BigF25/Harvester-measurement-and-control-system/1.hardware/PCBProj/参考/ST-link/QQ截图20220219135628.jpg

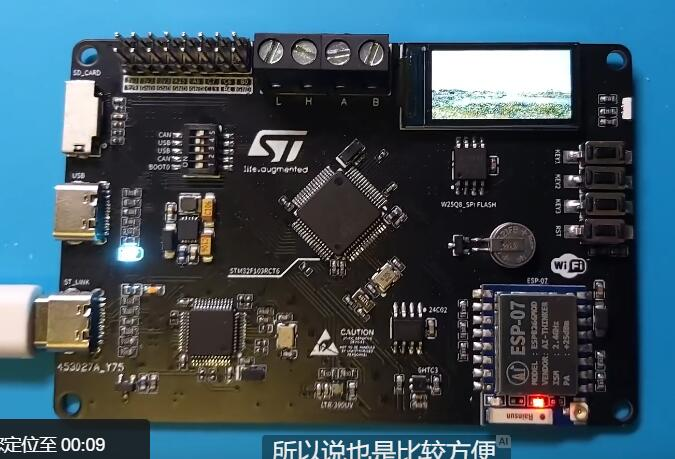
1.hardware/PCBProj/参考/ST-link/QQ截图20220219135628.jpg
