BigF25/Harvester-measurement-and-control-system/2.software/2-code/past/chuankouping/images/ID_0主界面按下.jpg

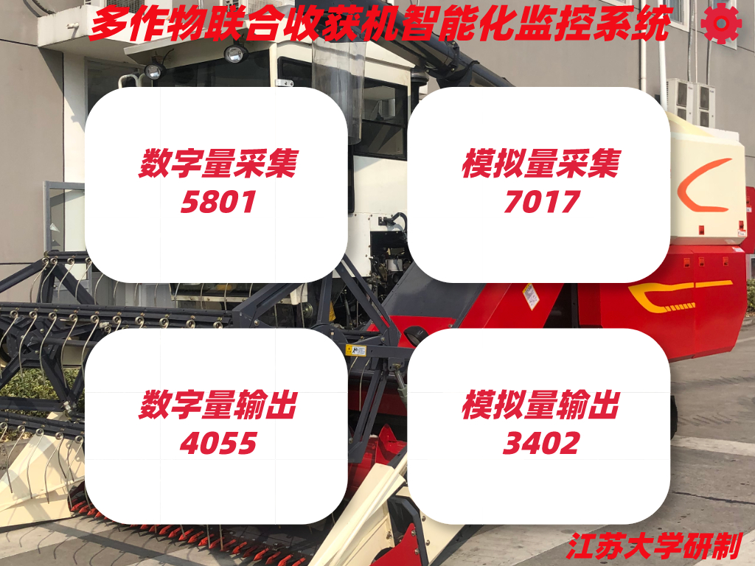
2.software/2-code/past/chuankouping/images/ID_0主界面按下.jpg
