BigF25/Harvester-measurement-and-control-system/3.docs/发票/嘉立创68元 (1).pdf

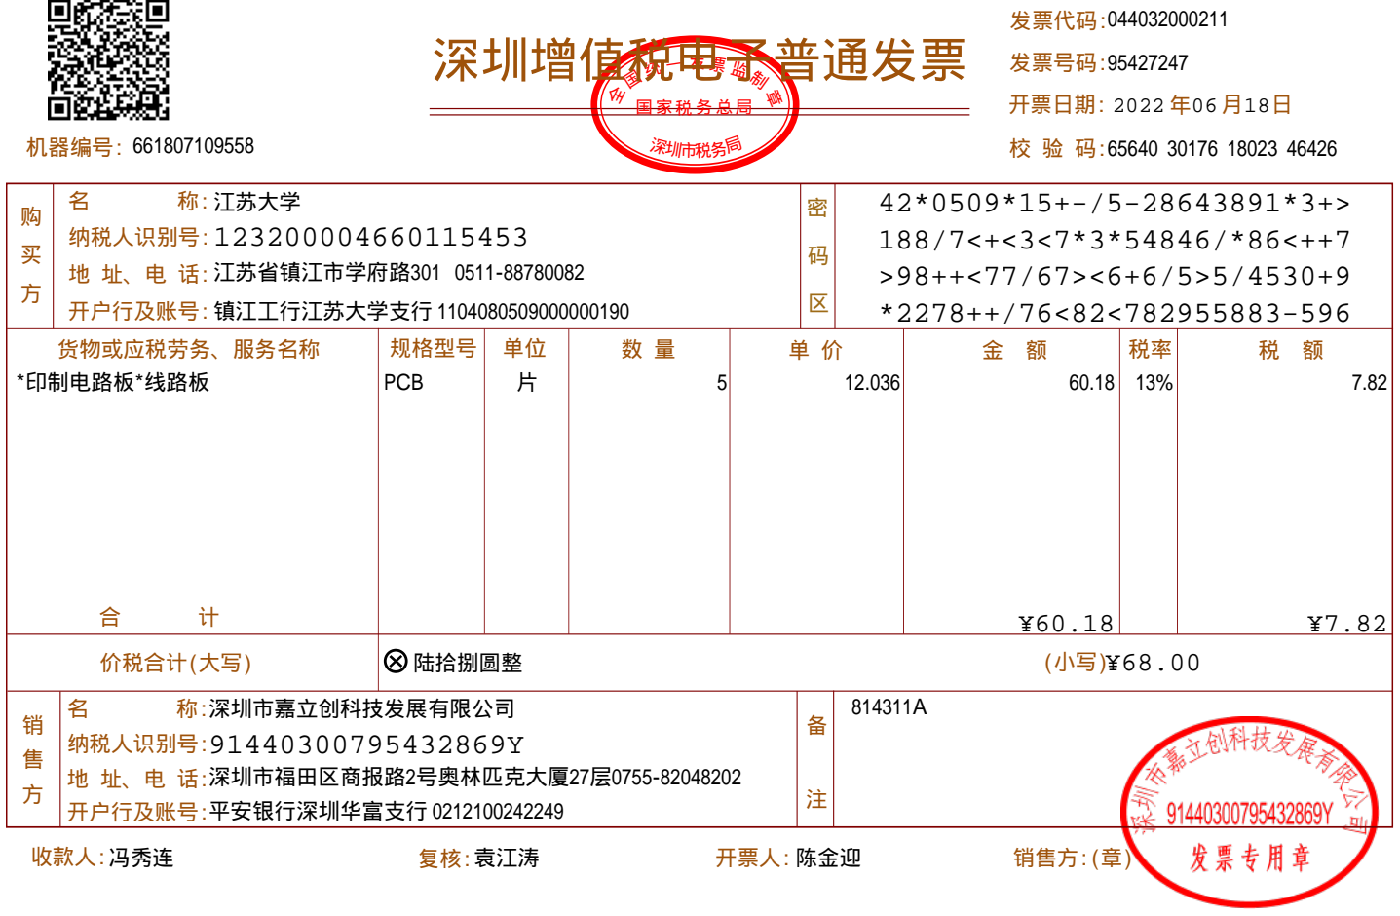
[picture p14: figure]
价税合计(大写); 纳税人识别号:; 开户行及账号:; 收款人:; 开票人:; 销售方:(章); 发票代码:; 发票号码:; 开票日期:; 货物或应税劳务、服务名称; 规格型号; 机器编号:; 市税务; 深圳增值税电子普通发票; 江苏大学; 江苏省镇江市学府路301 0511-88780082; 镇江工行江苏大学支行 1104080509000000190; 陆拾捌圆整; 深圳市嘉立创科技发展有限公司; 91440300795432869Y 深圳市福田区商报路2号奥林匹克大厦27层0755-82048202; 平安银行深圳华富支行 0212100242249; 冯秀连; 袁江涛; 陈金迎; *印制电路板*线路板; PCB
