BigF25/Harvester-measurement-and-control-system/1.hardware/PCBProj/参考/正点原子 STM32F407 探索者原理图和PCB图/ReadMe.txt

更新的时候请注意不要把USB上的GND和LOGO更新掉谢谢。
也可以复制后更新。
