BigF25/Harvester-measurement-and-control-system/3.docs/放弃办理授权资助情况说明.docx

放弃办理授权资助情况说明

专利名称
发明人
专利号
专利申请日
专利权人
授通日
放弃原因 | | 专利权人变更（或专利权人+发明人同时变更）
放弃原因具体说明 | 上述案件因发明人在申请专利之初对“专利权人”的内涵理解不够透彻，现需要变更“专利权人”，为避免办登费的缴纳期限延误，该专利的办登费由发明人自行缴纳，因发明人原因造成的办登费延迟缴纳等问题，造成的一切后果由发明人自己负责。
发 明 人 代 表 | （签字） 年 月 日 | | 所 属 学 院 | （学院盖章） 年 月 日
返还江苏大学专利基金资助流程 | 1、 发明人需返还申请阶段学校资助的申请费，填写 “江苏大学返回专利基金登记表” （注：申请日在2016年9月1日之前，返还金额为2840元；申请日在2016年9月1日（含9月1日）之后，2020年3月1日之前，返还金额为2670元；申请日在2020年3月1日（含3月1日）之后，返还为1780元。） 2、 发明人需将此情况说明和“江苏大学返回专利基金登记表”一同交至老图书馆506张蕾处。
