BigF25/Harvester-measurement-and-control-system/3.docs/江大软著准备材料/源代码——多作物联合收获机智能化监控系统.docx

多作物联合收获机智能化监控系统

V1.0

源代码

一、main.c中

int main() {

////////////////////System Init//////////////////////////////

NVIC_PriorityGroupConfig(NVIC_PriorityGroup_2); //设置系统中断优先级分组2

delay_init(168); //初始化延时函数

uart_init(115200); //初始化串口 波特率为115200

USART2_Init(115200); //初始化usart串口2

USART3_Init(115200); //初始化usart串口3

BEEP_Init();//初始化蜂鸣器

My_RTC_Init();

RTC_Set_WakeUp(RTC_WakeUpClock_CK_SPRE_16bits,0); //初始化RTC

CAN1_Mode_Init(CAN_SJW_1tq,CAN_BS2_6tq,CAN_BS1_7tq,6,CAN_Mode_Normal);

TIM3_Int_Init(999,71); //初始化定时器1ms

LCD_Init();

BUTTON_Init();

////////////////////can Init//////////////////////////////

Init_3402(ADDRESS_3402);

enable_TPDO(ADDRESS_3402, _TPDO1, TPDOCOMMAND_NO);

enable_TPDO(ADDRESS_3402, _TPDO2, TPDOCOMMAND_NO);delay_ms(100);

enable_TPDO(ADDRESS_3402, _TPDO3, TPDOCOMMAND_NO);

enable_TPDO(ADDRESS_3402, _TPDO4, TPDOCOMMAND_NO);delay_ms(100);

enable_TPDO(ADDRESS_5801_1, _TPDO1, TPDOCOMMAND_YES);

enable_TPDO(ADDRESS_5801_1, _TPDO2, TPDOCOMMAND_YES);delay_ms(100);

enable_TPDO(ADDRESS_5801_1, _TPDO3, TPDOCOMMAND_YES);

enable_TPDO(ADDRESS_5801_1, _TPDO4, TPDOCOMMAND_YES);delay_ms(100);

enable_TPDO(ADDRESS_5801_2, _TPDO1, TPDOCOMMAND_YES);

enable_TPDO(ADDRESS_5801_2, _TPDO2, TPDOCOMMAND_YES);delay_ms(100);

enable_TPDO(ADDRESS_5801_2, _TPDO3, TPDOCOMMAND_YES);

enable_TPDO(ADDRESS_5801_2, _TPDO4, TPDOCOMMAND_YES);delay_ms(100);

Init_4055(id);

Init_5801(ADDRESS_5801_1, 0xff);delay_ms(100);

Init_5801(ADDRESS_5801_2, 0x07);delay_ms(100);

enable_TPDO(ADDRESS_5801_2, _TPDO2, TPDOCOMMAND_YES);delay_ms(100);

Init_7017(ADDRESS_7017);delay_ms(100);

enable_TPDO(ADDRESS_7017, _TPDO1, TPDOCOMMAND_YES);delay_ms(100);

enable_TPDO(ADDRESS_7017, _TPDO2, TPDOCOMMAND_YES);delay_ms(100);

////////////////5801 清零////////////////////////

u8 clear_temp[8] = {0, 0, 0, 0, 1, 1, 1, 1};

Set_5801_ClearCount(ADDRESS_5801_2, clear_temp);//清零计数通道

////////////////////SD卡 FATFS Init////////////////////////

usmart_dev.init(84); //初始化USMART

W25QXX_Init(); //初始化W25Q128

my_mem_init(SRAMIN); //初始化内部内存池

my_mem_init(SRAMCCM); //初始化CCM内存池

if(SD_Init()) //初始化SD卡

;//SD Card Error!

else

{

exfuns_init();//为fatfs相关变量申请内存

f_mount(fs[0],"0:",1);//挂载SD卡

if(exf_getfree("0",NULL,NULL))

my_comscreen.sd_ready_flag = 0;//SD Card Fatfs Error!

else

my_comscreen.sd_ready_flag = 1;//SD Card Ready!

}

////////////////串口屏初始化//////////////////////////////

systicket_init();//配置时钟节拍

queue_reset();//清空串口接收缓冲区

delay_ms(300);//延时等待串口屏初始化完毕,必须等待300ms

/////////////////LCD初始化//////////////////////////////

POINT_COLOR=RED;//设置字体为红色

LCD_ShowString(20,20,200,16,16,"can_send_msg");

POINT_COLOR=BLUE;//设置字体为蓝色

qsize size = 0;

u8 canbuf[8];

u8 key;

my_comscreen.sys_init_ready=1;

while(1)

{

qsize size = 0;

USART3_Receive_Data(my_comscreen_value.cmd_buffer,&size);

if(size>0)

screen_ID_case();

if(my_comscreen.scr_can_but_flag == 1)

rec_can_value(my_comscreen.scr_5801_result_int, my_comscreen.scr_7017_result_int);

// BUTTON_C1 = 1;

set(BUTTON_B5,BUTTON_C1);

set(BUTTON_B6,BUTTON_C2);

set(BUTTON_B7,BUTTON_C3);

set(BUTTON_B8,BUTTON_C4);

set(BUTTON_B12,BUTTON_C5);

set(BUTTON_B13,BUTTON_C6);

}

}

二、timer.c中

void TIM3_IRQHandler(void)

{

if(TIM_GetITStatus(TIM3,TIM_IT_Update)==SET) //溢出中断

{

static int timer_count = 0;

timer_count++;

//sd卡检测

if(my_comscreen.sys_init_ready==1 && timer_count%1000==0)

{

if(SD_GetState() == SD_CARD_ERROR)

{

my_comscreen.sd_ready_flag = 0;

const u8 LEN = 64;

u8comscreen_send_msg[LEN] = {0xEE,0xB1,0x10,0x00,0x00,

0x00,0x06,0x53,0x44,

0xBF,0xA8,0xB4,0xED,0xCE,

0xF3,0xFF,0xFC,0xFF,0xFF };

my_USART_Send_Data(comscreen_send_msg,LEN);

}

else

{

my_comscreen.sd_ready_flag = 1;

const u8 LEN = 64;

u8 comscreen_send_msg[LEN] = {0xEE,0xB1,0x10,0x00,0x00,0x00,0x

06,0x53,0x44,0xBF,0xA8,0xD5,0xFD,0xB3

,0xA3,0xFF,0xFC,0xFF,0xFF };

my_USART_Send_Data(comscreen_send_msg,LEN);

}

}

//can接收

if(timer_count%300==0 && my_comscreen.scr_can_but_flag == 1)

{

//5801

static u8 countconscreen = 0;

// rec_can_value(my_comscreen.scr_5801_result_int, my_comscreen.scr_7017_result_int);

sprintf(my_comscreen.scr_5801_result_char[0], "%.2f", my_comscreen.scr_5801_result_int[0]*0.6);

sprintf(my_comscreen.scr_5801_result_char[1], "%.2f", my_comscreen.scr_5801_result_int[1]*0.6);

sprintf(my_comscreen.scr_5801_result_char[2], "%.2f", my_comscreen.scr_5801_result_int[2]*0.6);

sprintf(my_comscreen.scr_5801_result_char[3], "%.2f", my_comscreen.scr_5801_result_int[3]*0.6);

sprintf(my_comscreen.scr_5801_result_char[4], "%.2f", my_comscreen.scr_5801_result_int[4]*0.6);

sprintf(my_comscreen.scr_5801_result_char[5], "%.2f", my_comscreen.scr_5801_result_int[5]*0.6);

sprintf(my_comscreen.scr_5801_result_char[6], "%.2f", my_comscreen.scr_5801_result_int[6]*0.6);

sprintf(my_comscreen.scr_5801_result_char[7], "%.2f", my_comscreen.scr_5801_result_int[7]*0.6);

sprintf(my_comscreen.scr_5801_result_char[8], "%.2f", my_comscreen.scr_5801_result_int[8]*0.6);

sprintf(my_comscreen.scr_5801_result_char[9], "%.2f", my_comscreen.scr_5801_result_int[9]*0.6);

u32 temp = my_comscreen.scr_5801_result_int[11] + my_comscreen.scr_5801_result_int[12] + my_comscreen.scr_5801_result_int[13] + my_comscreen.scr_5801_result_int[15];

// sprintf(my_comscreen.scr_5801_result_char[10], "%d", my_comscreen.scr_5801_result_int[10]);

// sprintf(my_comscreen.scr_5801_result_char[11], "%d", my_comscreen.scr_5801_result_int[11]);

// sprintf(my_comscreen.scr_5801_result_char[12], "%d", my_comscreen.scr_5801_result_int[12]);

// sprintf(my_comscreen.scr_5801_result_char[13], "%d", my_comscreen.scr_5801_result_int[13]);

sprintf(my_comscreen.scr_5801_result_char[14], "%d", my_comscreen.scr_5801_result_int[14]);

sprintf(my_comscreen.scr_5801_result_char[15], "%d", temp);

const u8 LEN = 64;

u8 comscreen_send_msg[LEN];

u8 need[5];

need[0]=0;need[1]=1;need[2]=2;need[3]=3;need[4]=4;

getsendmsg_5801(comscreen_send_msg, 5, 1, need);

my_USART_Send_Data(comscreen_send_msg,LEN);

need[0]=5;need[1]=6;need[2]=7;need[3]=8;need[4]=9;

getsendmsg_5801(comscreen_send_msg, 5, 2, need);

my_USART_Send_Data(comscreen_send_msg,LEN);

need[0]=14;need[1]=15;

getsendmsg_5801(comscreen_send_msg, 2, 3, need);

my_USART_Send_Data(comscreen_send_msg,LEN);

//7017

sprintf(my_comscreen.scr_7017_result_char[0], "%d", my_comscreen.scr_7017_result_int[0]);

sprintf(my_comscreen.scr_7017_result_char[1], "%d", my_comscreen.scr_7017_result_int[1]);

sprintf(my_comscreen.scr_7017_result_char[2], "%d", my_comscreen.scr_7017_result_int[2]);

sprintf(my_comscreen.scr_7017_result_char[3], "%d", my_comscreen.scr_7017_result_int[3]);

sprintf(my_comscreen.scr_7017_result_char[4], "%d", my_comscreen.scr_7017_result_int[4]);

sprintf(my_comscreen.scr_7017_result_char[5], "%d", my_comscreen.scr_7017_result_int[5]);

sprintf(my_comscreen.scr_7017_result_char[6], "%d", my_comscreen.scr_7017_result_int[6]);

// sprintf(my_comscreen.scr_7017_result_char[7], "%d", my_comscreen.scr_7017_result_int[7]);

need[0]=0;need[1]=1;need[2]=2;need[3]=3;need[4]=4;

getsendmsg_7017(comscreen_send_msg, 5, 4, need);

my_USART_Send_Data(comscreen_send_msg,LEN);

need[0]=5;need[1]=6;

getsendmsg_7017(comscreen_send_msg, 2, 8, need);

my_USART_Send_Data(comscreen_send_msg,LEN);

}

//sd卡写入

if(timer_count%200==0 && my_comscreen.sd_ready_flag == 1 && my_comscreen.scr_sd_but_flag == 1)

{

LCD_ShowString(200,200,200,16,16,"sdon");

{

FIL fil;

UINT bww;

u8 res;

char temp[200];

RTC_TimeTypeDef RTC_TimeStruct;

RTC_DateTypeDef RTC_DateStruct;

RTC_GetTime(RTC_Format_BIN,&RTC_TimeStruct);

RTC_GetDate(RTC_Format_BIN,&RTC_DateStruct);

sprintf(temp, "0:/5801_20%d-%02d-%02d %02dh.xls", RTC_DateStruct.RTC_Year, RTC_DateStruct.RTC_Month, RTC_DateStruct.RTC_Date, RTC_TimeStruct.RTC_Hours);

res=f_open(&fil,temp,FA_CREATE_NEW | FA_WRITE);

if(res)

{

f_open(&fil,temp,FA_OPEN_EXISTING | FA_WRITE);

res=f_lseek(&fil,f_size(&fil));

sprintf(temp, "20%d-%02d-%02d\t%02d:%02d:%02d\t", RTC_DateStruct.RTC_Year, RTC_DateStruct.RTC_Month, RTC_DateStruct.RTC_Date,RTC_TimeStruct.RTC_Hours,RTC_TimeStruct.RTC_Minutes,RTC_TimeStruct.RTC_Seconds);

for(int i=0; i<10; i++)

{

char tempp[20];

sprintf(tempp, "%s\t", my_comscreen.scr_5801_result_char[i]);

strcat(temp,tempp);

}

{

char tempp[20];

sprintf(tempp, "%s\t", my_comscreen.scr_5801_result_char[15]);

strcat(temp,tempp);

sprintf(tempp, "%s\t", my_comscreen.scr_5801_result_char[14]);

strcat(temp,tempp);

}

strcat(temp,"\n");

f_write(&fil,temp,strlen(temp), &bww);

f_close(&fil);

}

else

{

sprintf(temp, "日期\t时间\t前进速度\t拨禾轮转速\t输送槽转速\t割台搅龙转速\t滚筒转速\t风机转速\t杂余搅龙转速\t籽粒搅龙转速\t碎草装置转速\t发动机转速\t籽粒夹带损失\t籽粒清选损失\n");

f_write(&fil,temp,strlen(temp), &bww);

f_close(&fil);

}

}

{

FIL fil;

UINT bww;

u8 res;

char temp[200];

RTC_TimeTypeDef RTC_TimeStruct;

RTC_DateTypeDef RTC_DateStruct;

RTC_GetTime(RTC_Format_BIN,&RTC_TimeStruct);

RTC_GetDate(RTC_Format_BIN,&RTC_DateStruct);

sprintf(temp, "0:/7017_20%d-%02d-%02d %02dh.xls", RTC_DateStruct.RTC_Year, RTC_DateStruct.RTC_Month, RTC_DateStruct.RTC_Date, RTC_TimeStruct.RTC_Hours);

res=f_open(&fil,temp,FA_CREATE_NEW | FA_WRITE);

if(res)

{

f_open(&fil,temp,FA_OPEN_EXISTING | FA_WRITE);

res=f_lseek(&fil,f_size(&fil));

sprintf(temp, "20%d-%02d-%02d\t%02d:%02d:%02d\t", RTC_DateStruct.RTC_Year, RTC_DateStruct.RTC_Month, RTC_DateStruct.RTC_Date,RTC_TimeStruct.RTC_Hours,RTC_TimeStruct.RTC_Minutes,RTC_TimeStruct.RTC_Seconds);

for(int i=0; i<7; i++)

{

char tempp[20];

sprintf(tempp, "%s\t", my_comscreen.scr_7017_result_char[i]);

strcat(temp,tempp);

}

strcat(temp,"\n");

f_write(&fil,temp,strlen(temp), &bww);

f_close(&fil);

}

else

{

sprintf(temp, "日期\t时间\t拨禾轮高度\t割台高度\t鱼鳞筛开度\t仿形板1角度\t仿形板2角度\t超声波1\t超声波2\n");

f_write(&fil,temp,strlen(temp), &bww);

f_close(&fil);

}

}

}

//电机

if(my_comscreen.scr_4055_motor1_but_ena_flag == 1 && timer_count % (11-my_comscreen.scr_4055_motor1_slider_value) == 0 )

{

static u8 flag = 0;

if(flag == 0)

my_comscreen.scr_4055_motor_can_send_msg = my_comscreen.scr_4055_motor_can_send_msg & 0xFB;//11111011

else if(flag == 1)

my_comscreen.scr_4055_motor_can_send_msg = my_comscreen.scr_4055_motor_can_send_msg | 0x04;//00000100

Set_4055_Switchoutput(ADDRESS_4055, my_comscreen.scr_4055_motor_can_send_msg);

flag = !flag;

}

if(my_comscreen.scr_4055_motor2_but_ena_flag == 1 && timer_count % (11-my_comscreen.scr_4055_motor2_slider_value) == 0 )

{

static u8 flag = 0;

if(flag == 0)

my_comscreen.scr_4055_motor_can_send_msg = my_comscreen.scr_4055_motor_can_send_msg & 0x7F;//01111111

else if(flag == 1)

my_comscreen.scr_4055_motor_can_send_msg = my_comscreen.scr_4055_motor_can_send_msg | 0x80;//10000000

Set_4055_Switchoutput(ADDRESS_4055, my_comscreen.scr_4055_motor_can_send_msg);

flag = !flag;

}

//溢出清零

if(timer_count == 10000) timer_count = 0;

}

TIM_ClearITPendingBit(TIM3,TIM_IT_Update); //清除中断标志位

}

三、canmodule.c中

void Init_3402(uint32_t id)

{

Set_3402_AOoutput_type(id, Output_pin_AO0, type_V);delay_ms(100);

Set_3402_AOoutput_type(id, Output_pin_AO1, type_V);delay_ms(100);

// enable_TPDO(id, _TPDO1, TPDOCOMMAND_NO);delay_ms(100);

// enable_TPDO(id, _TPDO2, TPDOCOMMAND_NO);delay_ms(100);

// enable_TPDO(id, _TPDO3, TPDOCOMMAND_NO);delay_ms(100);

// enable_TPDO(id, _TPDO4, TPDOCOMMAND_NO);delay_ms(100);

}

u8 Set_3402_Analogoutput(uint32_t id, u16 ao_0, u16 ao_1)

{

u8 mbox;

u8 ao_00, ao_01, ao_10, ao_11;

ao_00 = ao_0 & 0x00ff; //低八位

ao_01 = ao_0 >> 8; //高八位

ao_10 = ao_1 & 0x00ff; //低八位

ao_11 = ao_1 >> 8; //高八位

u16 i=0;

CanTxMsg TxMessage;

TxMessage.StdId=0x200+id; // 标准标识符为0

TxMessage.ExtId=0x200+id; // 设置扩展标示符（29位）

TxMessage.IDE=0; // 使用扩展标识符

TxMessage.RTR=0; // 消息类型为数据帧，一帧8位

TxMessage.DLC=5;

TxMessage.Data[0]=0x03;

TxMessage.Data[1]=ao_00;

TxMessage.Data[2]=ao_01;

TxMessage.Data[3]=ao_10;

TxMessage.Data[4]=ao_11;

mbox= CAN_Transmit(CAN1, &TxMessage);

while((CAN_TransmitStatus(CAN1, mbox)==CAN_TxStatus_Failed)&&(i<0XFFF))i++; //等待发送结束

if(i>=0XFFF)return 1;

return 0;

}

u8 Set_3402_AOoutput_type(uint32_t id, Output_pin pin, Output_type type)

{

u8 mbox;

u16 i=0;

CanTxMsg TxMessage;

TxMessage.StdId=0x600+id; // 标准标识符为0

TxMessage.ExtId=0x600+id; // 设置扩展标示符（29位）

TxMessage.IDE=0; // 使用扩展标识符

TxMessage.RTR=0; // 消息类型为数据帧，一帧8位

TxMessage.DLC=8;

TxMessage.Data[0]=0x2F;

TxMessage.Data[1]=0x09;

TxMessage.Data[2]=0x20;

TxMessage.Data[3]=pin;

TxMessage.Data[4]=type;

TxMessage.Data[5]=0x00;

TxMessage.Data[6]=0x00;

TxMessage.Data[7]=0x00;

mbox= CAN_Transmit(CAN1, &TxMessage);

while((CAN_TransmitStatus(CAN1, mbox)==CAN_TxStatus_Failed)&&(i<0XFFF))i++; //等待发送结束

if(i>=0XFFF)return 1;

return 0;

}

void Init_4055(uint32_t id)

{

Set_4055_Safety_output(id, 0xFF);delay_ms(100);

enable_TPDO(id, _TPDO1, TPDOCOMMAND_NO);delay_ms(100);

enable_TPDO(id, _TPDO2, TPDOCOMMAND_NO);delay_ms(100);

enable_TPDO(id, _TPDO3, TPDOCOMMAND_NO);delay_ms(100);

enable_TPDO(id, _TPDO4, TPDOCOMMAND_NO);delay_ms(100);

}

u8 Set_4055_Switchoutput(uint32_t id, u8 digital_output)

{

u8 mbox;

u16 i=0;

CanTxMsg TxMessage;

TxMessage.StdId=0x200+id; // 标准标识符为0

TxMessage.ExtId=0x200+id; // 设置扩展标示符（29位）

TxMessage.IDE=0; // 使用扩展标识符

TxMessage.RTR=0; // 消息类型为数据帧，一帧8位

TxMessage.DLC=1;

TxMessage.Data[0] = digital_output;

mbox= CAN_Transmit(CAN1, &TxMessage);

while((CAN_TransmitStatus(CAN1, mbox)==CAN_TxStatus_Failed)&&(i<0XFFF))i++; //等待发送结束

if(i>=0XFFF)return 1;

return 0;

}

u8 Set_4055_Safety_output(uint32_t id, u8 type_DO)

{

u8 mbox;

u16 i=0;

CanTxMsg TxMessage;

TxMessage.StdId=0x600+id; // 标准标识符为0

TxMessage.ExtId=0x600+id; // 设置扩展标示符（29位）

TxMessage.IDE=0; // 使用扩展标识符

TxMessage.RTR=0; // 消息类型为数据帧，一帧8位

TxMessage.DLC=8;

TxMessage.Data[0]=0x2F;

TxMessage.Data[1]=0x01;

TxMessage.Data[2]=0x20;

TxMessage.Data[3]=0x01;

TxMessage.Data[4]=type_DO;

TxMessage.Data[5]=0x00;

TxMessage.Data[6]=0x00;

TxMessage.Data[7]=0x00;

mbox= CAN_Transmit(CAN1, &TxMessage);

while((CAN_TransmitStatus(CAN1, mbox)==CAN_TxStatus_Failed)&&(i<0XFFF))i++; //等待发送结束

if(i>=0XFFF)return 1;

return 0;

}

void Init_5801(u8 address, u8 value)

{

Set_5801_Frequency_Type(address, value);delay_ms(100);//0xFF所有通道设为测频率模式

Set_5801_Filter_Time(address, Passageway_CF0, Filtertime_10);delay_ms(100);//设置通道0 1滤波时间

Set_5801_Filter_Time(address, Passageway_CF1, Filtertime_10);delay_ms(100);//设置通道0 1滤波时间

Set_5801_Filter_Time(address, Passageway_CF2, Filtertime_10);delay_ms(100);//设置通道0 1滤波时间

Set_5801_Filter_Time(address, Passageway_CF3, Filtertime_10);delay_ms(100);//设置通道0 1滤波时间

Set_5801_Filter_Time(address, Passageway_CF4, Filtertime_10);delay_ms(100);//设置通道0 1滤波时间

Set_5801_Filter_Time(address, Passageway_CF5, Filtertime_10);delay_ms(100);//设置通道0 1滤波时间

Set_5801_Filter_Time(address, Passageway_CF6, Filtertime_10);delay_ms(100);//设置通道0 1滤波时间

Set_5801_Filter_Time(address, Passageway_CF7, Filtertime_10);delay_ms(100);//设置通道0 1滤波时间

Set_5801_Excessive_Time(address, Passageway_CF0, 0x32);delay_ms(100);

Set_5801_Excessive_Time(address, Passageway_CF1, 0x32);delay_ms(100);

Set_5801_Excessive_Time(address, Passageway_CF2, 0x32);delay_ms(100);

Set_5801_Excessive_Time(address, Passageway_CF3, 0x32);delay_ms(100);

Set_5801_Excessive_Time(address, Passageway_CF4, 0x32);delay_ms(100);

Set_5801_Excessive_Time(address, Passageway_CF5, 0x32);delay_ms(100);

Set_5801_Excessive_Time(address, Passageway_CF6, 0x32);delay_ms(100);

Set_5801_Excessive_Time(address, Passageway_CF7, 0x32);delay_ms(100);

lapsetime_TPDO(address, _TPDO1, 10);delay_ms(100);

lapsetime_TPDO(address, _TPDO2, 10);delay_ms(100);

lapsetime_TPDO(address, _TPDO3, 10);delay_ms(100);

lapsetime_TPDO(address, _TPDO4, 10);delay_ms(100);

event_TPDO(address, _TPDO1, 50);delay_ms(100);

event_TPDO(address, _TPDO2, 50);delay_ms(100);

event_TPDO(address, _TPDO3, 50);delay_ms(100);//100

event_TPDO(address, _TPDO4, 50);delay_ms(100);

}

u8 rec_5801_ImpulseValue(uint32_t ID, u32 *resut_int)//读取频率值

{

u8 buf[8];

CanRxMsg RxMessage;

if( CAN_MessagePending(CAN1,CAN_FIFO0)==0) return 0; //没有接收到数据,直接退出

CAN_Receive(CAN1, CAN_FIFO0, &RxMessage);//读取数据

for(u32 i=0;i<RxMessage.DLC;i++)

buf[i]=RxMessage.Data[i];

uint32_t id = RxMessage.StdId;

static int count = 0;

count+=50;

LCD_ShowxNum(count,70,id,4,16,0);//delay_ms(1000);

if(count > 800)count = 0;

if(id == 0x180+ID)

{

resut_int[0] = buf[0]+buf[1]*256+buf[2]*65536+buf[3]*16777216;//通道0

resut_int[1] = buf[4]+buf[5]*256+buf[6]*65536+buf[7]*16777216;//通道1

static int i = 0;i++;

LCD_ShowxNum(10,100,i,4,16,0);//delay_ms(1000);

}

else if(id == 0x280+ID)

{

resut_int[2] = buf[0]+buf[1]*256+buf[2]*65536+buf[3]*16777216;//通道2

resut_int[3] = buf[4]+buf[5]*256+buf[6]*65536+buf[7]*16777216;//通道3

static int i = 0;i++;

LCD_ShowxNum(10,120,i,4,16,0);//delay_ms(1000);

}

else if(id == 0x380+ID)

{

resut_int[4] = buf[0]+buf[1]*256+buf[2]*65536+buf[3]*16777216;//通道4

resut_int[5] = buf[4]+buf[5]*256+buf[6]*65536+buf[7]*16777216;//通道5

static int i = 0;i++;

LCD_ShowxNum(10,140,i,4,16,0);//delay_ms(1000);

}

else if(id == 0x480+ID)

{

resut_int[6] = buf[0]+buf[1]*256+buf[2]*65536+buf[3]*16777216;//通道6

resut_int[7] = buf[4]+buf[5]*256+buf[6]*65536+buf[7]*16777216;//通道7

static int i = 0;i++;

LCD_ShowxNum(10,160,i,4,16,0);//delay_ms(1000);

}

return RxMessage.DLC;

}

u8 rec_5801_CountValue(uint32_t ID, u32 resut_int[8])//读取计数值

{

u8 buf[8];

CanRxMsg RxMessage;

if( CAN_MessagePending(CAN1,CAN_FIFO0)==0) return 0; //没有接收到数据,直接退出

CAN_Receive(CAN1, CAN_FIFO0, &RxMessage);//读取数据

for(u32 i=0;i<RxMessage.DLC;i++)

buf[i]=RxMessage.Data[i];

uint32_t id = RxMessage.StdId;

if(id == 0x180+ID)

{

resut_int[0] = buf[0]+buf[1]*256+buf[2]*65536+buf[3]*16777216;//通道0

resut_int[1] = buf[4]+buf[5]*256+buf[6]*65536+buf[7]*16777216;//通道1

}

else if(id == 0x280+ID)

{

resut_int[2] = buf[0]+buf[1]*256+buf[2]*65536+buf[3]*16777216;//通道2

resut_int[3] = buf[4]+buf[5]*256+buf[6]*65536+buf[7]*16777216;//通道3

}

else if(id == 0x380+ID)

{

resut_int[4] = buf[0]+buf[1]*256+buf[2]*65536+buf[3]*16777216;//通道4

resut_int[5] = buf[4]+buf[5]*256+buf[6]*65536+buf[7]*16777216;//通道5

}

else if(id == 0x480+ID)

{

resut_int[6] = buf[0]+buf[1]*256+buf[2]*65536+buf[3]*16777216;//通道6

resut_int[7] = buf[4]+buf[5]*256+buf[6]*65536+buf[7]*16777216;//通道7

}

return RxMessage.DLC;

}

u8 Set_5801_Frequency_Type(uint32_t id, uint8_t type)//设置模块为测频或计数模式，0为计数模式，1为测频模式

{ //由type的值确定各个通道的具体模式

u8 mbox;

u16 i=0;

CanTxMsg TxMessage;

TxMessage.StdId=0x600+id; // 标准标识符为0

TxMessage.ExtId=0x600+id; // 设置扩展标示符（29位）

TxMessage.IDE=0; // 使用扩展标识符

TxMessage.RTR=0; // 消息类型为数据帧，一帧8位

TxMessage.DLC=8;

TxMessage.Data[0]=0x2B;

TxMessage.Data[1]=0x00;

TxMessage.Data[2]=0x20;

TxMessage.Data[3]=0x01;

TxMessage.Data[4]=type;

TxMessage.Data[5]=0x00;

TxMessage.Data[6]=0x00;

TxMessage.Data[7]=0x00;

mbox= CAN_Transmit(CAN1, &TxMessage);

while((CAN_TransmitStatus(CAN1, mbox)==CAN_TxStatus_Failed)&&(i<0XFFF))i++; //等待发送结束

if(i>=0XFFF)return 1;

return 0;

}

u8 Set_5801_ClearCount(uint32_t id, u8 count_clear[8])//清零计数通道

{

u8 mbox;

u16 i=0;

CanTxMsg TxMessage;

TxMessage.StdId=0x200+id; // 标准标识符为0

TxMessage.ExtId=0x200+id; // 设置扩展标示符（29位）

TxMessage.IDE=0; // 使用扩展标识符

TxMessage.RTR=0; // 消息类型为数据帧，一帧8位

TxMessage.DLC=8;

TxMessage.Data[0]=count_clear[0];//0x01//清零

TxMessage.Data[1]=count_clear[1];//0x00//不清零

TxMessage.Data[2]=count_clear[2];//0x01//清零

TxMessage.Data[3]=count_clear[3];//0x01//清零

TxMessage.Data[4]=count_clear[4];//0x00//不清零

TxMessage.Data[5]=count_clear[5];//0x01//清零

TxMessage.Data[6]=count_clear[6];//0x01//清零

TxMessage.Data[7]=count_clear[7];//0x00//不清零

mbox= CAN_Transmit(CAN1, &TxMessage);

while((CAN_TransmitStatus(CAN1, mbox)==CAN_TxStatus_Failed)&&(i<0XFFF))i++; //等待发送结束

if(i>=0XFFF)return 1;

return 0;

}

u8 Set_5801_Filter_Time(uint32_t id, EMPPassageway Passageway, EMPFiltertime Filtertime)//设置模块测频通道滤波时间

{

u8 mbox;

u16 i=0;

CanTxMsg TxMessage;

TxMessage.StdId=0x580+id; // 标准标识符为0

TxMessage.ExtId=0x580+id; // 设置扩展标示符（29位）

TxMessage.IDE=0; // 使用扩展标识符

TxMessage.RTR=0; // 消息类型为数据帧，一帧8位

TxMessage.DLC=8;

TxMessage.Data[0]=0x2B;

TxMessage.Data[1]=0x07;

TxMessage.Data[2]=0x20;

TxMessage.Data[3]=Passageway;//具体配置哪个通道

TxMessage.Data[4]=Filtertime;//滤波时间

TxMessage.Data[5]=0x00;

TxMessage.Data[6]=0x00;

TxMessage.Data[7]=0x00;

mbox= CAN_Transmit(CAN1, &TxMessage);

while((CAN_TransmitStatus(CAN1, mbox)==CAN_TxStatus_Failed)&&(i<0XFFF))i++; //等待发送结束

if(i>=0XFFF)return 1;

return 0;

}

u8 Set_5801_Excessive_Time(uint32_t id, EMPPassageway Passageway, uint8_t Excessivetime)//设置模块测频超时时间（设置为最小频率的周期）

{ //0x32=50，50*100ms=5s，定时5s

u8 mbox; //0x0A=10，10*100ms=5s，定时1s

u16 i=0;

CanTxMsg TxMessage;

TxMessage.StdId=0x600+id; // 标准标识符为0

TxMessage.ExtId=0x600+id; // 设置扩展标示符（29位）

TxMessage.IDE=0; // 使用扩展标识符

TxMessage.RTR=0; // 消息类型为数据帧，一帧8位

TxMessage.DLC=8;

TxMessage.Data[0]=0x2B;

TxMessage.Data[1]=0x08;

TxMessage.Data[2]=0x20;

TxMessage.Data[3]=Passageway;

TxMessage.Data[4]=Excessivetime;//设置的测频更新时间（单位 100ms）所以更新时间是 Excessivetime*100ms

TxMessage.Data[5]=0x00;

TxMessage.Data[6]=0x00;

TxMessage.Data[7]=0x00;

mbox= CAN_Transmit(CAN1, &TxMessage);

while((CAN_TransmitStatus(CAN1, mbox)==CAN_TxStatus_Failed)&&(i<0XFFF))i++; //等待发送结束

if(i>=0XFFF)return 1;

return 0;

}

void Init_7017(uint32_t ID)

{

Set_7017_AiType(ID, AiType_5V);delay_ms(100);

Set_7017_AiEnable(ID, AiChannel_ALL);delay_ms(100);

Set_7017_AiDataType(ID, ANALOG_VALUE);delay_ms(100);

Set_7017_AiNumberOfFilters(ID, AiNumOfFilters(5));delay_ms(100);

lapsetime_TPDO(ID, _TPDO1, 999);delay_ms(100);

lapsetime_TPDO(ID, _TPDO2, 999);delay_ms(100);

event_TPDO(ID, _TPDO1, 100);delay_ms(100);

event_TPDO(ID, _TPDO2, 100);delay_ms(100);

}

u8 rec_7017_AiValue(uint32_t ID, u16 resut_char[8])//读取 AI 模拟量输入

{

u8 buf[8];

CanRxMsg RxMessage;

if( CAN_MessagePending(CAN1,CAN_FIFO0)==0) return 0; //没有接收到数据,直接退出

CAN_Receive(CAN1, CAN_FIFO0, &RxMessage);//读取数据

for(u32 i=0;i<RxMessage.DLC;i++)

buf[i]=RxMessage.Data[i];

uint32_t id = RxMessage.StdId;

if(id == 0x180+ID)

{

resut_char[0] = (u16)(buf[0]+buf[1]*256);

resut_char[1] = (u16)(buf[2]+buf[3]*256);

resut_char[2] = (u16)(buf[4]+buf[5]*256);

resut_char[3] = (u16)(buf[6]+buf[7]*256);

static int m = 0;m++;

LCD_ShowxNum(70,100,m,4,16,0);//delay_ms(1000);

}

else if(id == 0x280+ID)

{

resut_char[4] = (u16)(buf[0]+buf[1]*256);

resut_char[5] = (u16)(buf[2]+buf[3]*256);

resut_char[6] = (u16)(buf[4]+buf[5]*256);

resut_char[7] = (u16)(buf[6]+buf[7]*256);

static int i = 0;i++;

LCD_ShowxNum(70,120,i,4,16,0);//delay_ms(1000);

}

return RxMessage.DLC;

}

u8 set_7017_DOBit(uint32_t id, u8 a)//设置 DO 开关量输出

{

u8 mbox;

u16 i=0;

CanTxMsg TxMessage;

TxMessage.StdId=0x200+id; // 标准标识符为0

TxMessage.ExtId=0x200+id; // 设置扩展标示符（29位）

TxMessage.IDE=0; // 使用扩展标识符

TxMessage.RTR=0; // 消息类型为数据帧，一帧8位

TxMessage.DLC=1;

if(a == 0)

TxMessage.Data[0]=0x00;

else if(a == 1)

TxMessage.Data[0]=0x01;

mbox= CAN_Transmit(CAN1, &TxMessage);

while((CAN_TransmitStatus(CAN1, mbox)==CAN_TxStatus_Failed)&&(i<0XFFF))i++; //等待发送结束

if(i>=0XFFF)return 1;

return 0;

}

u8 rec_7017_msg(uint32_t *id, u8 *buf)

{

CanRxMsg RxMessage;

if( CAN_MessagePending(CAN1,CAN_FIFO0)==0) return 0; //没有接收到数据,直接退出

CAN_Receive(CAN1, CAN_FIFO0, &RxMessage);//读取数据

for(u32 i=0;i<RxMessage.DLC;i++)

buf[i]=RxMessage.Data[i];

*id = RxMessage.StdId;

return RxMessage.DLC;

}

u8 send_7017_msg(uint32_t id)

{

u8 mbox;

u16 i=0;

CanTxMsg TxMessage;

TxMessage.StdId=0x600+id; // 标准标识符为0

TxMessage.ExtId=0x600+id; // 设置扩展标示符（29位）

TxMessage.IDE=0; // 使用扩展标识符

TxMessage.RTR=0; // 消息类型为数据帧，一帧8位

TxMessage.DLC=8;

TxMessage.Data[0]=0x40;

TxMessage.Data[1]=0x09;

TxMessage.Data[2]=0x20;

TxMessage.Data[3]=0x01;

TxMessage.Data[4]=0x00;

TxMessage.Data[5]=0x00;

TxMessage.Data[6]=0x00;

TxMessage.Data[7]=0x00;

mbox= CAN_Transmit(CAN1, &TxMessage);

while((CAN_TransmitStatus(CAN1, mbox)==CAN_TxStatus_Failed)&&(i<0XFFF))i++; //等待发送结束

if(i>=0XFFF)return 1;

return 0;

}

u8 Set_7017_AiType(uint32_t id, AiType type)//设置模块的 AIN 采集类型

{

u8 mbox;

u16 i=0;

CanTxMsg TxMessage;

TxMessage.StdId=0x600+id; // 标准标识符为0

TxMessage.ExtId=0x600+id; // 设置扩展标示符（29位）

TxMessage.IDE=0; // 使用扩展标识符

TxMessage.RTR=0; // 消息类型为数据帧，一帧8位

TxMessage.DLC=8;

TxMessage.Data[0]=0x2F;

TxMessage.Data[1]=0x04;

TxMessage.Data[2]=0x20;

TxMessage.Data[3]=0x01;

TxMessage.Data[4]=type;

TxMessage.Data[5]=0x00;

TxMessage.Data[6]=0x00;

TxMessage.Data[7]=0x00;

mbox= CAN_Transmit(CAN1, &TxMessage);

while((CAN_TransmitStatus(CAN1, mbox)==CAN_TxStatus_Failed)&&(i<0XFFF))i++; //等待发送结束

if(i>=0XFFF)return 1;

return 0;

}

u8 Set_7017_AiEnable(uint32_t id, AiChannel channel)//设置模块的 AI 采集通道使能

{

u8 mbox;

u16 i=0;

CanTxMsg TxMessage;

TxMessage.StdId=0x600+id; // 标准标识符为0

TxMessage.ExtId=0x600+id; // 设置扩展标示符（29位）

TxMessage.IDE=0; // 使用扩展标识符

TxMessage.RTR=0; // 消息类型为数据帧，一帧8位

TxMessage.DLC=8;

TxMessage.Data[0]=0x2F;

TxMessage.Data[1]=0x03;

TxMessage.Data[2]=0x20;

TxMessage.Data[3]=0x01;

TxMessage.Data[4]=channel;

TxMessage.Data[5]=0x00;

TxMessage.Data[6]=0x00;

TxMessage.Data[7]=0x00;

mbox= CAN_Transmit(CAN1, &TxMessage);

while((CAN_TransmitStatus(CAN1, mbox)==CAN_TxStatus_Failed)&&(i<0XFFF))i++; //等待发送结束

if(i>=0XFFF)return 1;

return 0;

}

u8 Set_7017_AiDataType(uint32_t id, AiDataType datatype)//设置模块 AI 的数据格式

{

u8 mbox;

u16 i=0;

CanTxMsg TxMessage;

TxMessage.StdId=0x600+id; // 标准标识符为0

TxMessage.ExtId=0x600+id; // 设置扩展标示符（29位）

TxMessage.IDE=0; // 使用扩展标识符

TxMessage.RTR=0; // 消息类型为数据帧，一帧8位

TxMessage.DLC=8;

TxMessage.Data[0]=0x2F;

TxMessage.Data[1]=0x08;

TxMessage.Data[2]=0x20;

TxMessage.Data[3]=0x01;

TxMessage.Data[4]=datatype;

TxMessage.Data[5]=0x00;

TxMessage.Data[6]=0x00;

TxMessage.Data[7]=0x00;

mbox= CAN_Transmit(CAN1, &TxMessage);

while((CAN_TransmitStatus(CAN1, mbox)==CAN_TxStatus_Failed)&&(i<0XFFF))i++; //等待发送结束

if(i>=0XFFF)return 1;

return 0;

}

u8 Set_7017_AiNumberOfFilters(uint32_t id, AiNum Ainum)//设置模块的采集滤波次数

{

u8 mbox;

u16 i=0;

CanTxMsg TxMessage;

TxMessage.StdId=0x600+id; // 标准标识符为0

TxMessage.ExtId=0x600+id; // 设置扩展标示符（29位）

TxMessage.IDE=0; // 使用扩展标识符

TxMessage.RTR=0; // 消息类型为数据帧，一帧8位

TxMessage.DLC=8;

TxMessage.Data[0]=0x2B;

TxMessage.Data[1]=0x09;

TxMessage.Data[2]=0x20;

TxMessage.Data[3]=0x01;

TxMessage.Data[4]=Ainum;

TxMessage.Data[5]=0x00;

TxMessage.Data[6]=0x00;

TxMessage.Data[7]=0x00;

mbox= CAN_Transmit(CAN1, &TxMessage);

while((CAN_TransmitStatus(CAN1, mbox)==CAN_TxStatus_Failed)&&(i<0XFFF))i++; //等待发送结束

if(i>=0XFFF)return 1;

return 0;

}

四、comscreen.c中

void screen_ID_case(void)

{

uint16 screen_id = PTR2U16(&((PCTRL_MSG)my_comscreen_value.cmd_buffer)->screen_id);

switch(screen_id)

{

case SCR_MAIN_ID:

break;

case SCR_5801_1_ID:

control_ID_case();

break;

case SCR_5801_2_ID:

control_ID_case();

break;

case SCR_7017_1_ID:

control_ID_case();

break;

case SCR_7017_2_ID:

control_ID_case();

break;

case SCR_4055_ID:

control_ID_case();

break;

case SCR_3402_ID:

control_ID_case();

break;

case SCR_SET_ID:

control_ID_case();

break;

default:

break;

}

}

void control_ID_case(void)

{

uint16 control_id = PTR2U16(&((PCTRL_MSG)my_comscreen_value.cmd_buffer)->control_id);

u8 button_state = ((PCTRL_MSG)my_comscreen_value.cmd_buffer)->param[1];

uint32 slider_4055_value = PTR2U32(((PCTRL_MSG)my_comscreen_value.cmd_buffer)->param);

static uint32 slider1_value = 0;

static uint32 slider2_value = 0;

switch(control_id)

{

case SCR_5801_1_CAN_BUT_ID:

my_comscreen.scr_can_but_flag = button_state;

break;

case SCR_5801_1_SD_BUT_ID:

my_comscreen.scr_sd_but_flag = button_state;

break;

case SCR_4055_MOTOR1_BUT_ENA_ID:

if(button_state == 0)

{

my_comscreen.scr_4055_motor_can_send_msg = my_comscreen.scr_4055_motor_can_send_msg & 0xFE;//11111110

my_comscreen.scr_4055_motor1_but_ena_flag = 0;

}

else if(button_state == 1)

{

my_comscreen.scr_4055_motor_can_send_msg = my_comscreen.scr_4055_motor_can_send_msg | 0x01;//00000001

my_comscreen.scr_4055_motor1_but_ena_flag = 1;

}

Set_4055_Switchoutput(ADDRESS_4055, my_comscreen.scr_4055_motor_can_send_msg);

break;

case SCR_4055_MOTOR1_BUT_DIR_ID:

if(button_state == 0)

{

my_comscreen.scr_4055_motor_can_send_msg = my_comscreen.scr_4055_motor_can_send_msg & 0xFD;//11111110

my_comscreen.scr_4055_motor1_but_dir_flag = 0;

}

else if(button_state == 1)

{

my_comscreen.scr_4055_motor_can_send_msg = my_comscreen.scr_4055_motor_can_send_msg | 0x02;//00000001

my_comscreen.scr_4055_motor1_but_dir_flag = 1;

}

Set_4055_Switchoutput(ADDRESS_4055, my_comscreen.scr_4055_motor_can_send_msg);

break;

case SCR_4055_MOTOR1_SLIDER_ID:

my_comscreen.scr_4055_motor1_slider_value = slider_4055_value;

break;

case SCR_4055_MOTOR2_BUT_ENA_ID:

if(button_state == 0)

{

my_comscreen.scr_4055_motor_can_send_msg = my_comscreen.scr_4055_motor_can_send_msg & 0xDF;//11111110

my_comscreen.scr_4055_motor2_but_ena_flag = 0;

}

else if(button_state == 1)

{

my_comscreen.scr_4055_motor_can_send_msg = my_comscreen.scr_4055_motor_can_send_msg | 0x20;//00000001

my_comscreen.scr_4055_motor2_but_ena_flag = 1;

}

Set_4055_Switchoutput(ADDRESS_4055, my_comscreen.scr_4055_motor_can_send_msg);

break;

case SCR_4055_MOTOR2_BUT_DIR_ID:

if(button_state == 0)

{

my_comscreen.scr_4055_motor_can_send_msg = my_comscreen.scr_4055_motor_can_send_msg & 0xBF;//11111110

my_comscreen.scr_4055_motor3_but_dir_flag = 0;

}

else if(button_state == 1)

{

my_comscreen.scr_4055_motor_can_send_msg = my_comscreen.scr_4055_motor_can_send_msg | 0x40;//00000001

my_comscreen.scr_4055_motor3_but_dir_flag = 1;

}

Set_4055_Switchoutput(ADDRESS_4055, my_comscreen.scr_4055_motor_can_send_msg);

break;

case SCR_4055_MOTOR2_SLIDER_ID:

my_comscreen.scr_4055_motor2_slider_value = slider_4055_value;

break;

case SCR_3402_SLIDER1_ID:

slider1_value = PTR2U32(((PCTRL_MSG)my_comscreen_value.cmd_buffer)->param);

Set_3402_Analogoutput(ADDRESS_3402, slider1_value, slider2_value);

break;

case SCR_3402_SLIDER2_ID:

slider2_value = PTR2U32(((PCTRL_MSG)my_comscreen_value.cmd_buffer)->param);

Set_3402_Analogoutput(ADDRESS_3402, slider1_value, slider2_value);

break;

case SCR_SET_SD_BUT_ID:

{

u32 total,free;

if(SD_GetState() == SD_CARD_ERROR)

{

if(SD_Init())

{

my_comscreen.sd_ready_flag = 0;

const u8 LEN = 64;

u8 comscreen_send_msg[LEN] = {0xEE,0xB1,0x10,0x00,0x07,0x00,0x02,0x53,0x44,0xBF,0xA8,0xB4,0xED,0xCE,0xF3,0xFF,0xFC,0xFF,0xFF };

my_USART_Send_Data(comscreen_send_msg,LEN);

}

else

{

exfuns_init(); //为fatfs相关变量申请内存

f_mount(fs[0],"0:",1); //挂载SD卡

if(exf_getfree("0",&total,&free))//SD Card Fatfs Error!

{

my_comscreen.sd_ready_flag = 0;

const u8 LEN = 64;

u8 comscreen_send_msg[LEN] = {0xEE,0xB1,0x10,0x00,0x07,0x00,0x02,0x53,0x44,0xBF,0xA8,0xB4,0xED,0xCE,0xF3,0xFF,0xFC,0xFF,0xFF };

my_USART_Send_Data(comscreen_send_msg,LEN);

}

else

goto A;//SD Card Ready!

}

}

else

{

exf_getfree("0",&total,&free);

A:

total = total>>10;

free = free>>10;

my_comscreen.sd_ready_flag = 1;

const u8 LEN = 64;

u8 comscreen_send_msg[LEN] = {0xEE,0xB1,0x10,0x00,0x07,0x00,0x02,0x53,0x44,0xBF,0xA8,0xD5,0xFD,0xB3,0xA3,0xFF,0xFC,0xFF,0xFF };

my_USART_Send_Data(comscreen_send_msg,LEN);

}

break;

}

}

}
