BigF25/Harvester-measurement-and-control-system/3.docs/发票/1 (1).pdf

# 江苏增值税电子普通发票

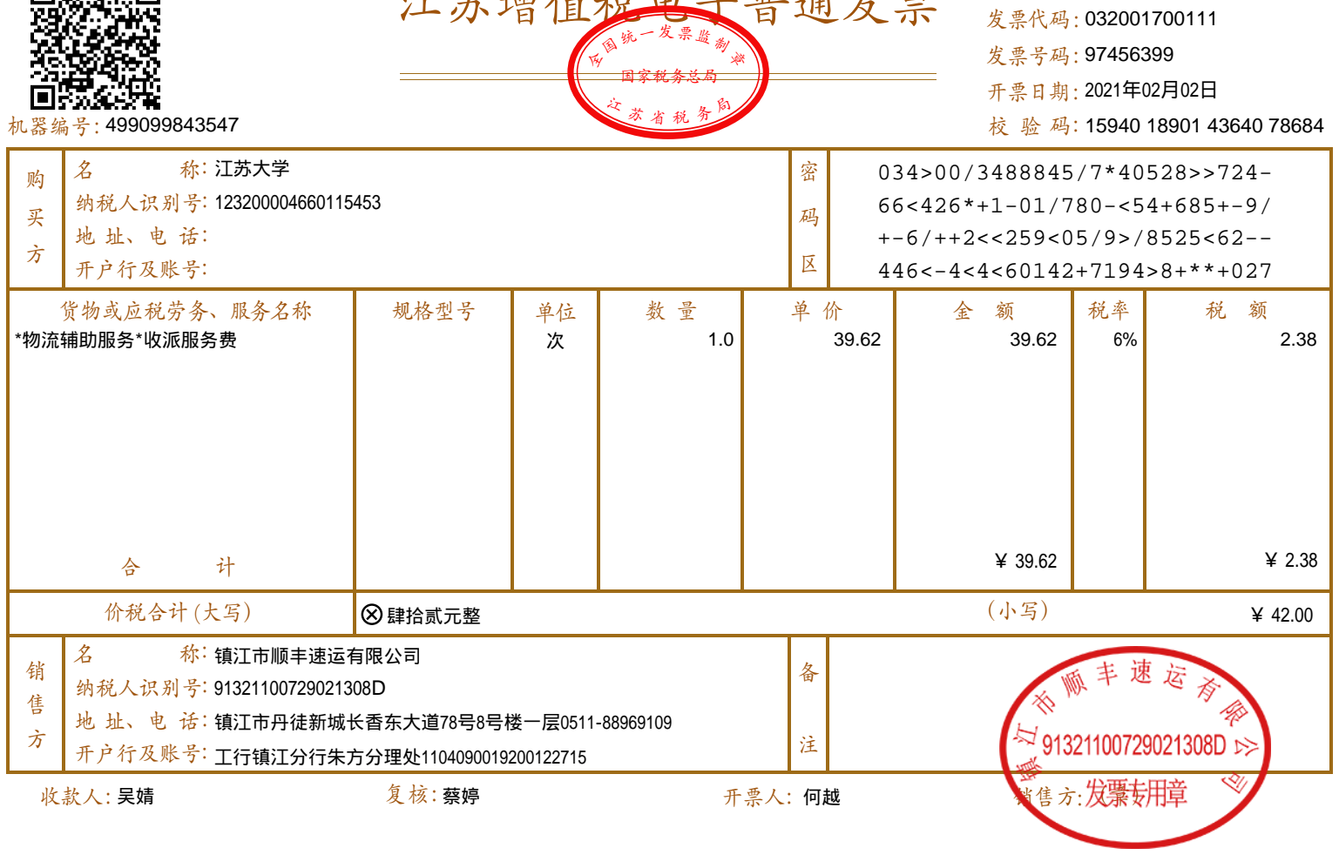
[picture p26: figure]
货物或应税劳务、服; 称名务; 规格型号; 价税合计 (大写）; （小写） ￥ 42.00 肆拾贰元整; 纳税人识别号： 地 址、电 话 ： 开户行及账号 ：; ： 人款收; 开票人：; 销售方： （章）; 发票号码 ：; 开票日期 ：; 发票代码; 机器编号 ：; 全国统一发票监制 章; 国家税务总局; 江苏大学; *物流辅助服务*收派服务费

销 售 方 | ： 名 称 镇江市顺丰速运有限公司 纳税人识别号： 91321100729021308D 地 址、电 话 ： 镇江市丹徒新城长香东大道78号8号楼一层0511-88969109 开户行及账号 ： 工行镇江分行朱方分理处1104090019200122715 | 备 注
