BigF25/Harvester-measurement-and-control-system/3.docs/发票/1 (2).pdf

# 浙江增值税电子普通发票

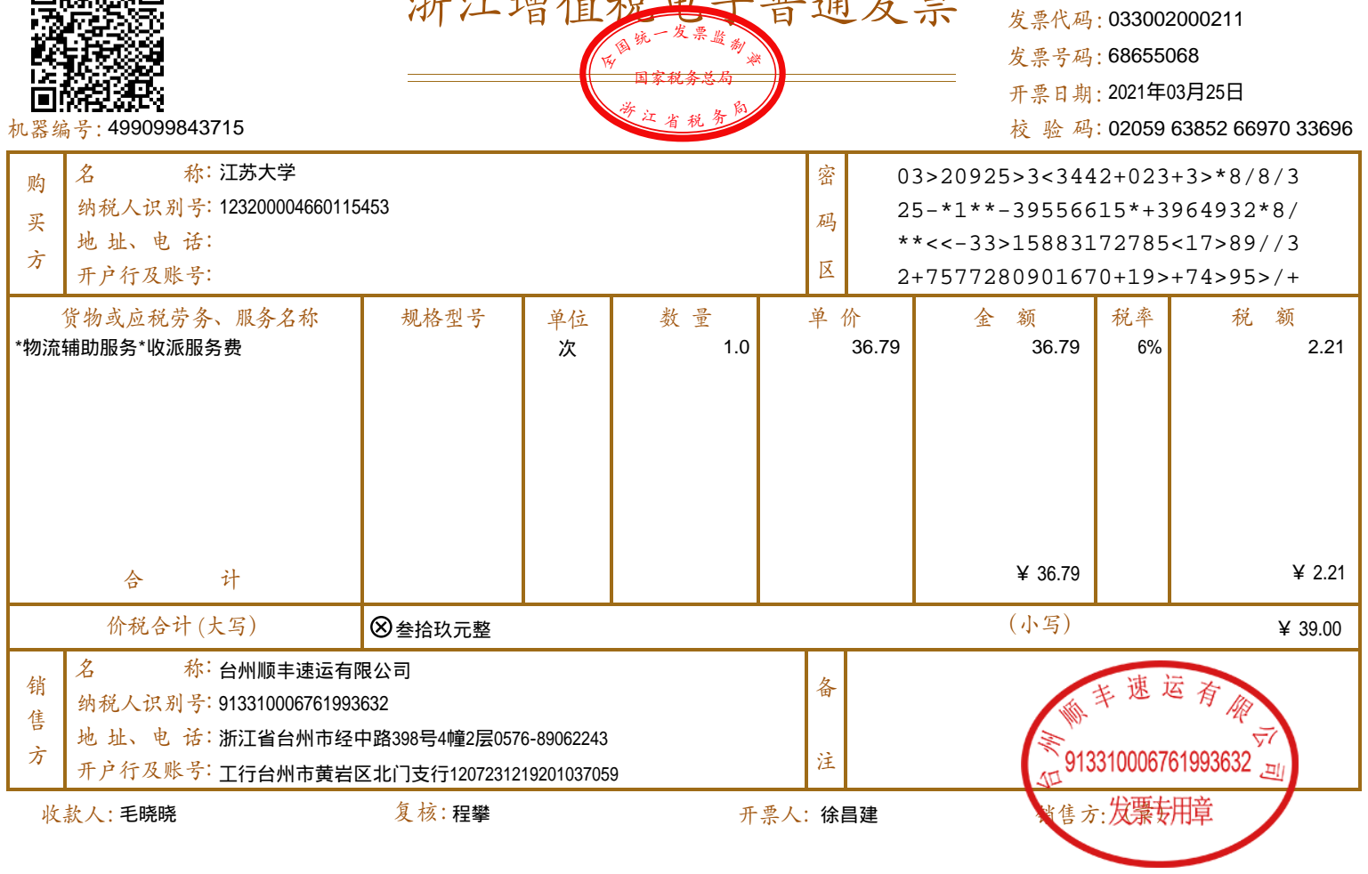
[picture p27: figure]
货物或应税劳务、服; 称名务; 规格型号; 价税合计 (大写）; （小写） ￥ 39.00 叁拾玖元整; 纳税人识别号： 地 址、电 话 ： 开户行及账号 ：; ： 人款收; 开票人：; 销售方： （章）; 发票号码 ：; 开票日期 ：; 发票代码; 机器编号 ：; 全国统一发票监制 章; 国家税务总局; 江苏大学; 毛晓晓; 徐昌建; *物流辅助服务*收派服务费

销 售 方 | ： 名 称 台州顺丰速运有限公司 纳税人识别号： 913310006761993632 地 址、电 话 ： 浙江省台州市经中路398号4幢2层0576-89062243 开户行及账号 ： 工行台州市黄岩区北门支行1207231219201037059 | 备 注
