BigF25/Harvester-measurement-and-control-system/3.docs/发票/2 (1).pdf

# 江西增值税电子普通发票

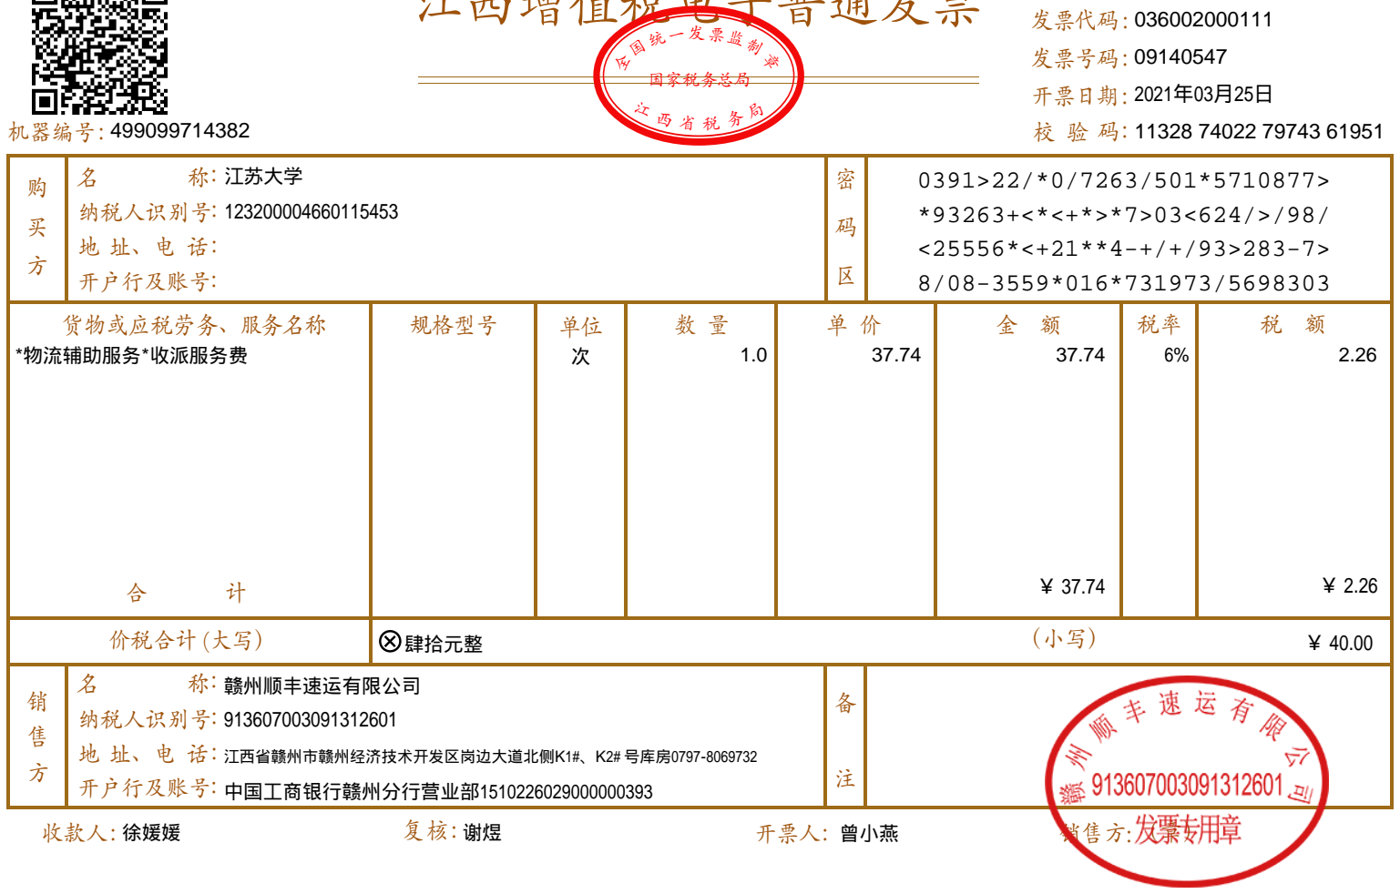
[picture p28: figure]
货物或应税劳务、服; 称名务; 规格型号; 价税合计 (大写）; （小写） ￥ 40.00 肆拾元整; 纳税人识别号： 地 址、电 话 ： 开户行及账号 ：; ： 人款收; 开票人：; 销售方： （章）; 发票号码 ：; 开票日期 ：; 发票代码; 机器编号 ：; 全国统一发票监制 章; 国家税务总局; 江苏大学; 徐媛媛; 曾小燕; *物流辅助服务*收派服务费

销 售 方 | ： 名 称 赣州顺丰速运有限公司 纳税人识别号： 913607003091312601 地 址、电 话 ： 江西省赣州市赣州经济技术开发区岗边大道北侧K1#、K2# 号库房0797-8069732 开户行及账号 ： 中国工商银行赣州分行营业部1510226029000000393 | 备 注
