BigF25/Harvester-measurement-and-control-system/3.docs/发票/3 (2).pdf

# 福建增值税电子普通发票

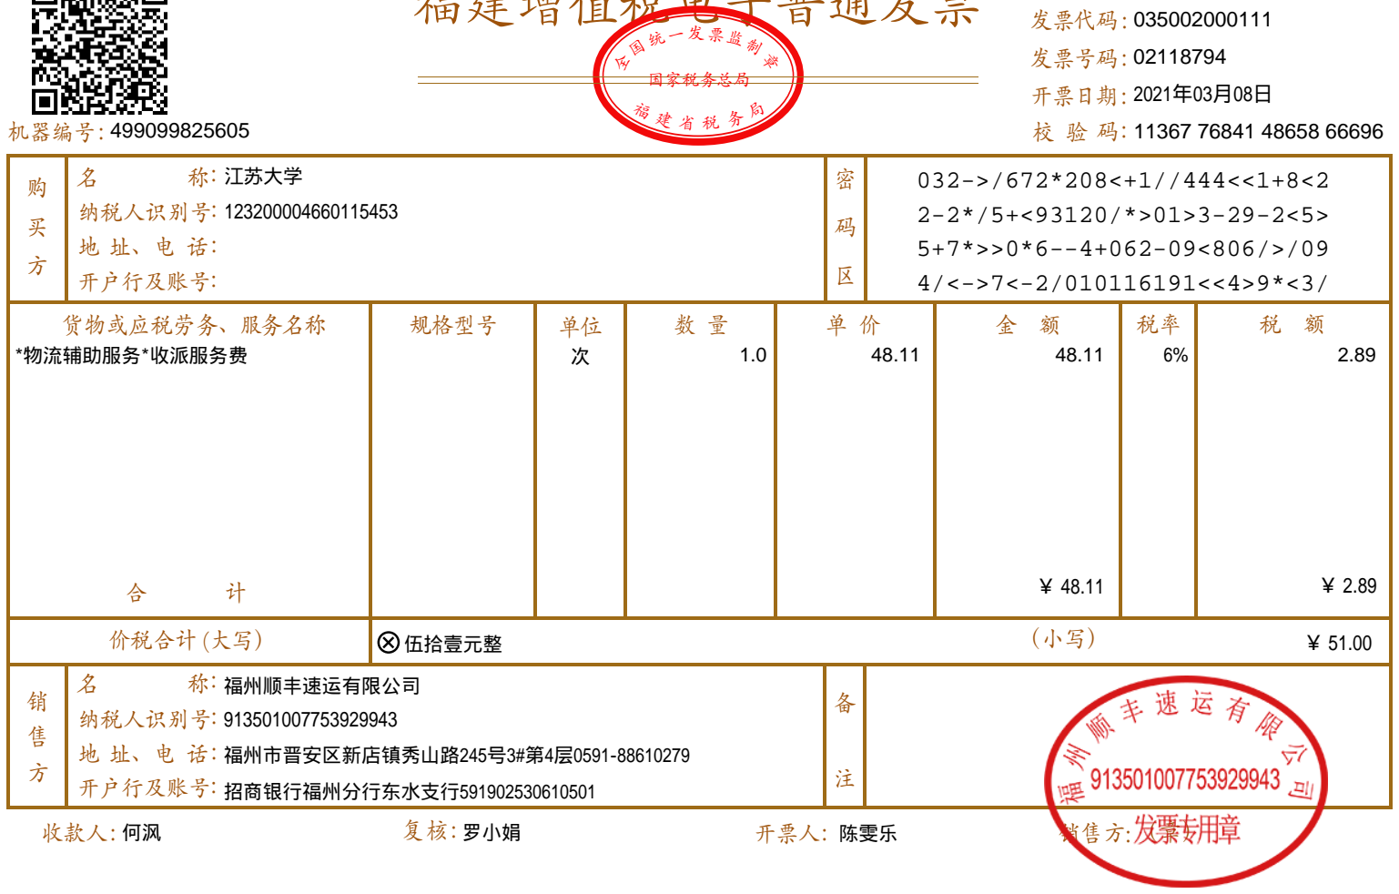
[picture p29: figure]
货物或应税劳务、服; 称名务; 规格型号; 价税合计 (大写）; （小写） ￥ 51.00 伍拾壹元整; 纳税人识别号： 地 址、电 话 ： 开户行及账号 ：; ： 人款收; 开票人：; 销售方： （章）; 发票号码 ：; 开票日期 ：; 发票代码; 机器编号 ：; 全国统一发票监制 章; 国家税务总局; 江苏大学; 罗小娟; 陈雯乐; *物流辅助服务*收派服务费

销 售 方 | ： 名 称 福州顺丰速运有限公司 纳税人识别号： 913501007753929943 地 址、电 话 ： 福州市晋安区新店镇秀山路245号3#第4层0591-88610279 开户行及账号 ： 招商银行福州分行东水支行591902530610501 | 备 注
