BigF25/Harvester-measurement-and-control-system/3.docs/发票/900电子元器件.pdf

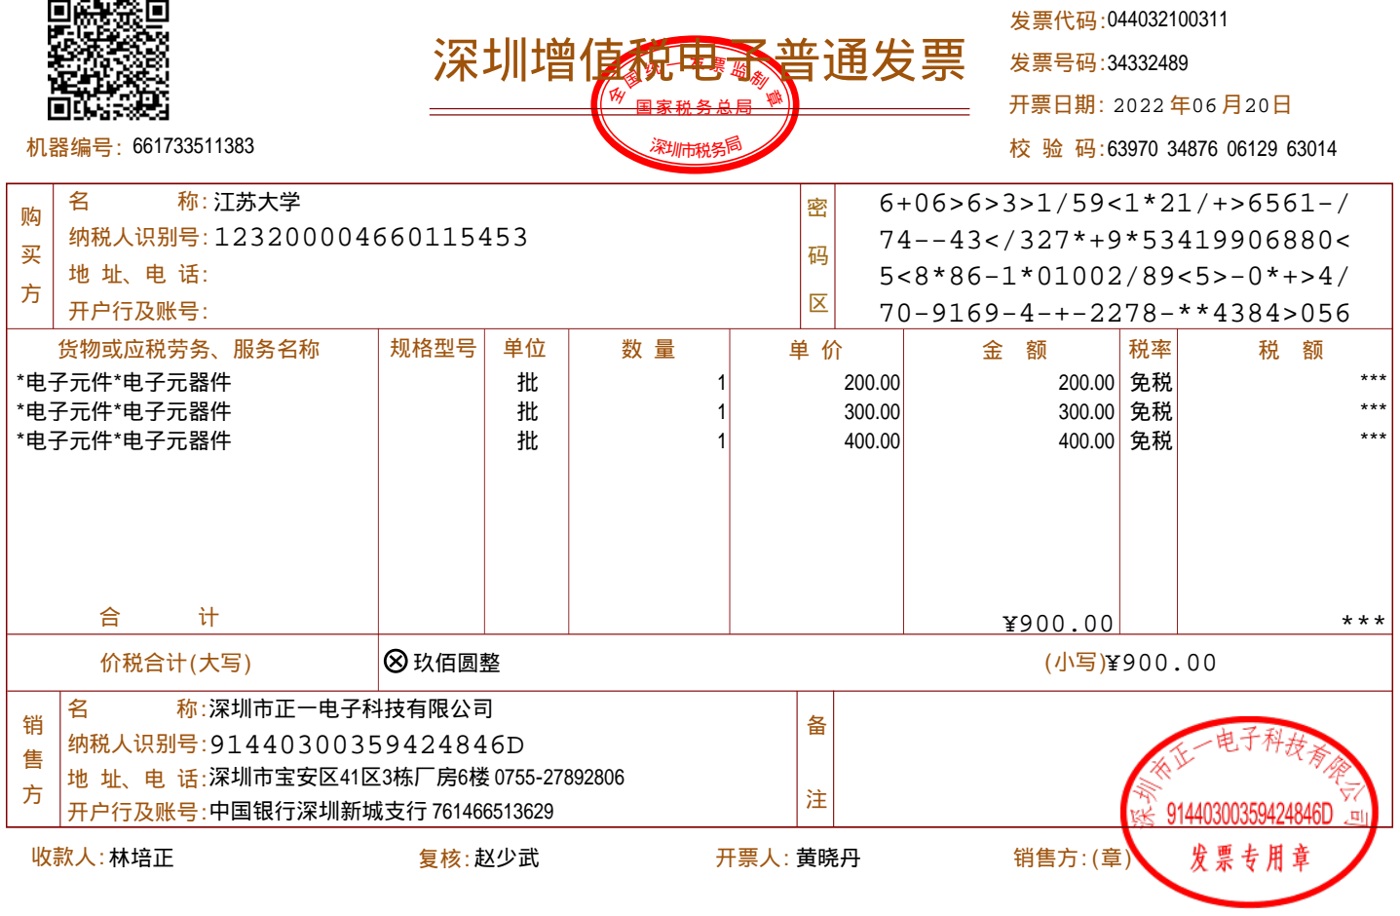
[picture p30: figure]
价税合计(大写); 纳税人识别号:; 开户行及账号:; 收款人:; 开票人:; 销售方:(章); 发票代码:; 发票号码:; 开票日期:; 货物或应税劳务、服务名称; 规格型号; 机器编号:; 市税务; 深圳增值税电子普通发票; 江苏大学; 玖佰圆整; 深圳市正一电子科技有限公司; 91440300359424846D 深圳市宝安区41区3栋厂房6楼 0755-27892806; 中国银行深圳新城支行 761466513629; 林培正; 赵少武; 黄晓丹; *电子元件*电子元器件
