BigF25/Harvester-measurement-and-control-system/3.docs/发票/江苏大学-210323.pdf

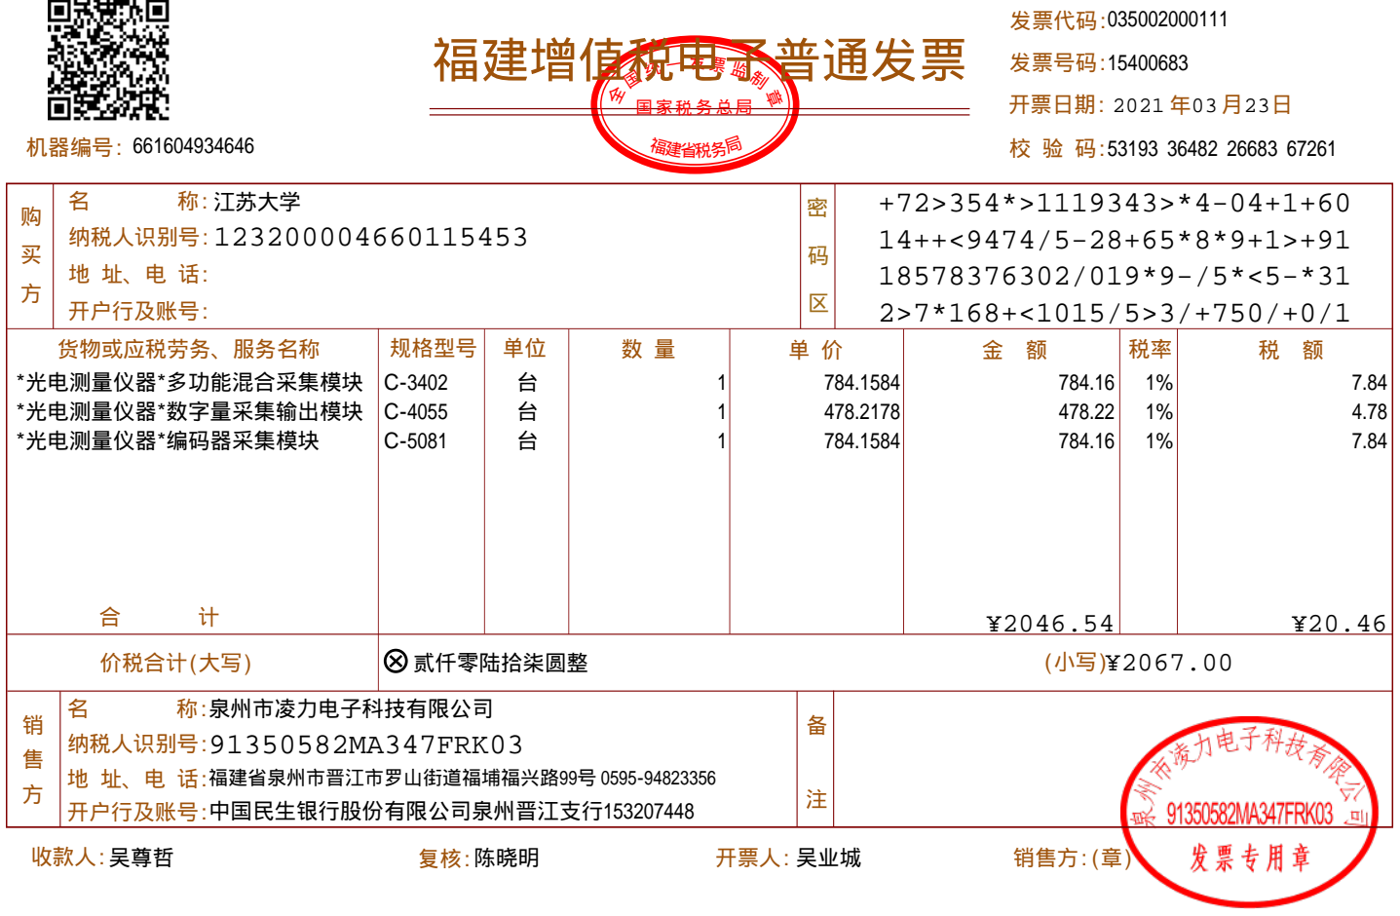
[picture p32: figure]
价税合计(大写); 纳税人识别号:; 开户行及账号:; 收款人:; 开票人:; 销售方:(章); 发票代码:; 发票号码:; 开票日期:; 货物或应税劳务、服务名称; 规格型号; 机器编号:; 省税务; 福建增值税电子普通发票; 江苏大学; 贰仟零陆拾柒圆整; 泉州市凌力电子科技有限公司; 91350582MA347FRK03; 福建省泉州市晋江市罗山街道福埔福兴路99号 0595-94823356 中国民生银行股份有限公司泉州晋江支行153207448; 吴尊哲; 陈晓明; 吴业城; *光电测量仪器*多功能混合采集模块; *光电测量仪器*数字量采集输出模块; *光电测量仪器*编码器采集模块
