BigF25/Harvester-measurement-and-control-system/2.software/2-code/past/2-com_screen/images/主界面.jpg

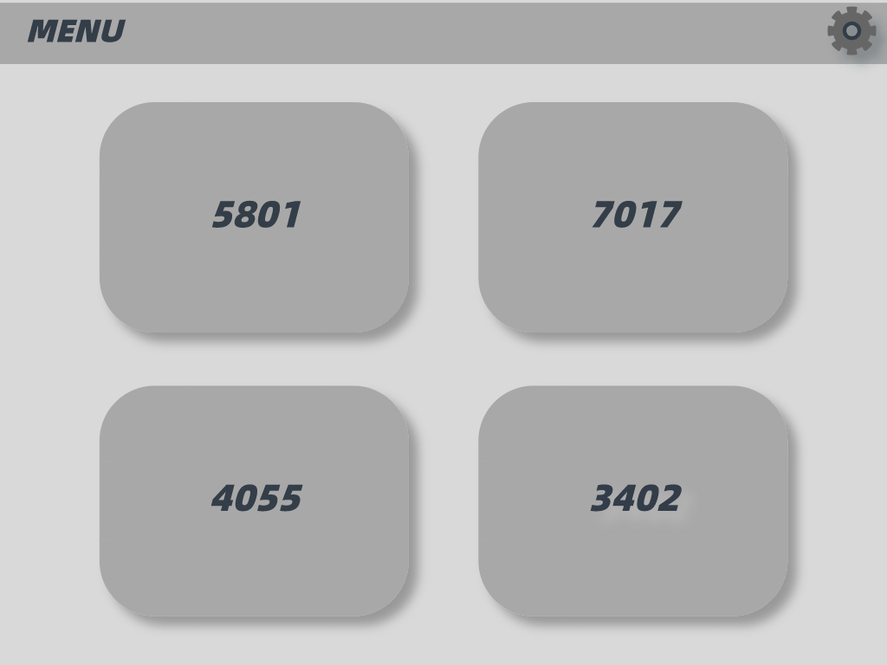
2.software/2-code/past/2-com_screen/images/主界面.jpg
