BigF25/Harvester-measurement-and-control-system/2.software/2-code/past/chuankouping/images/ID_1_5801.jpg

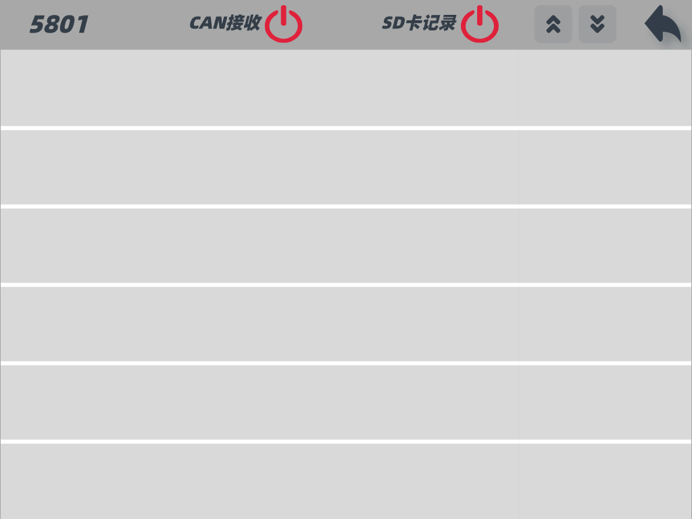
2.software/2-code/past/chuankouping/images/ID_1_5801.jpg
