BigF25/Harvester-measurement-and-control-system/2.software/2-code/past/chuankouping/images/ID_3_4055.jpg

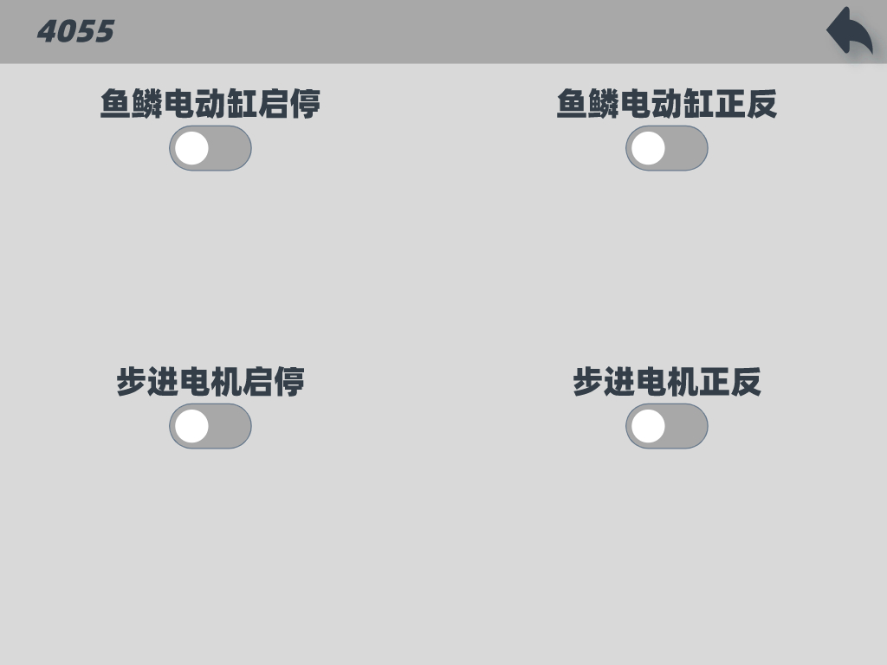
2.software/2-code/past/chuankouping/images/ID_3_4055.jpg
