BigF25/Harvester-measurement-and-control-system/2.software/2-code/past/chuankouping/images/ID_4_3402.jpg

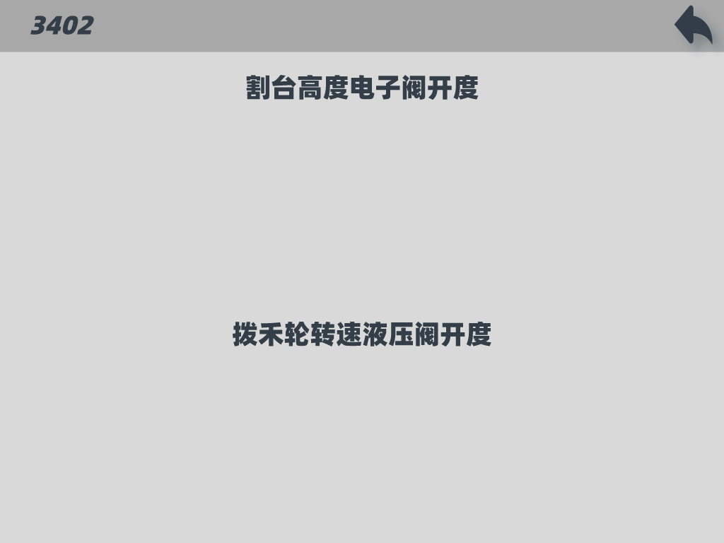
2.software/2-code/past/chuankouping/images/ID_4_3402.jpg
