BigF25/Harvester-measurement-and-control-system/2.software/2-code/past/chuankouping/images/设置.jpg

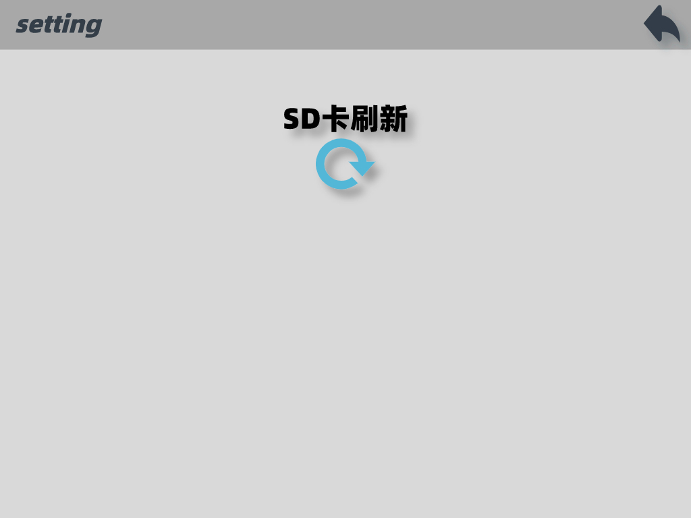
2.software/2-code/past/chuankouping/images/设置.jpg
