BigF25/Harvester-measurement-and-control-system/3.docs/任务.jpg

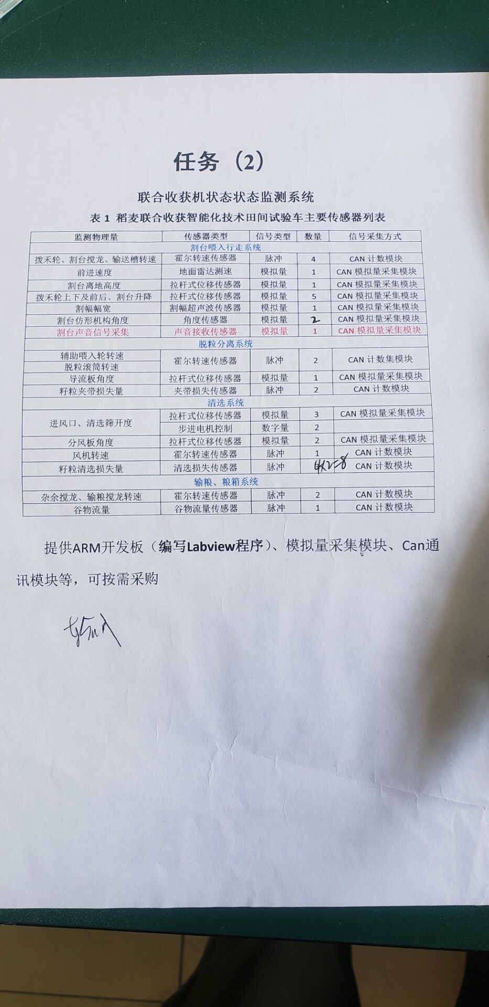
3.docs/任务.jpg
