BigF25/Harvester-measurement-and-control-system/3.docs/思维导图.jpg

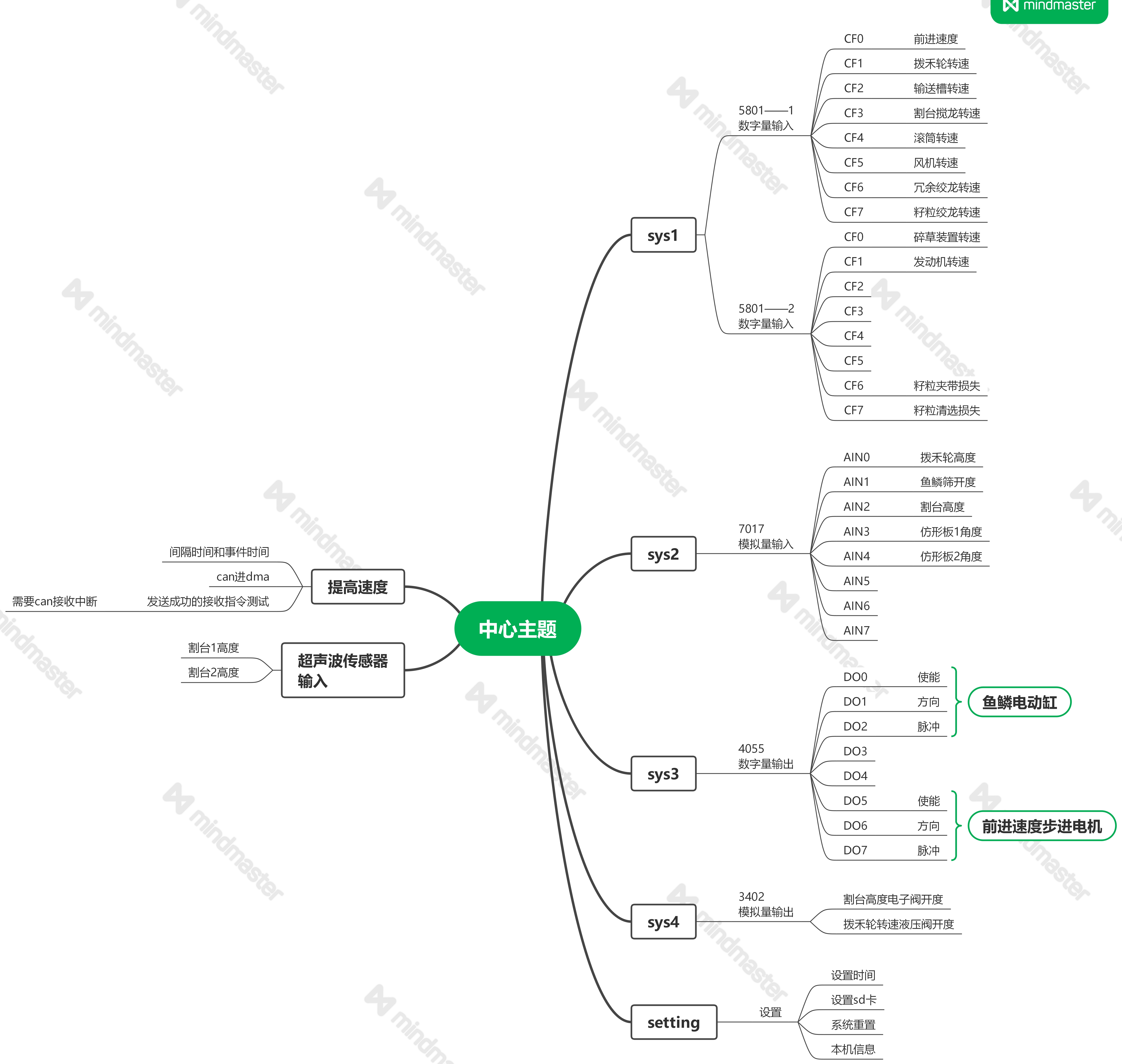
3.docs/思维导图.jpg
