BigF25/Harvester-measurement-and-control-system/3.docs/软著登记步骤2.JPG

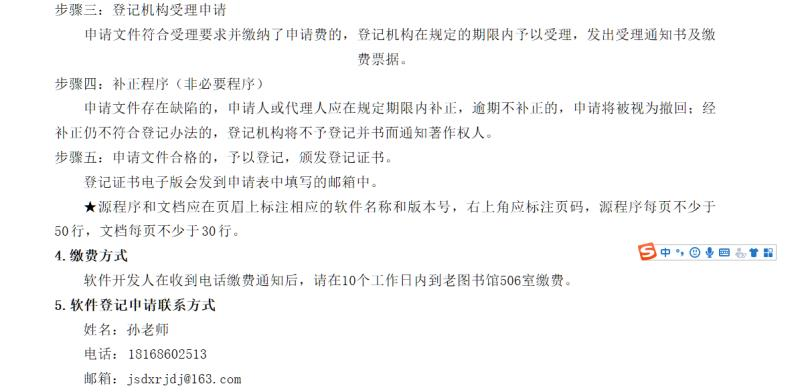
3.docs/软著登记步骤2.JPG
