BigF25/Harvester-measurement-and-control-system/1.hardware/PCBProj/主板/output/BOM.xls

Comment | Description | Designator | Footprint | LibRef | Quantity
BATT |  | BAT1 | CR1220_B | BAT | 1
BEEP |  | BEEP1 | BEEP 5x9x5.5 | BEEP | 1
150 |  | C1, C2 | C 0805_L | C | 2
100 |  | C3, C4 | C 0805_L | C | 2
104 |  | C5, C6, C7, C10, C15, C16, C17, C18, C19, C20, C21, C22, C23, C24, C25, C26, C28, C29, C30, C31, C32, C33, C34, C35, C36, C37, C38, C39, C40, C41, C42, C43, C45, C46, C47, C48, C49, C50, C52, C53, C54, C56, C57 | C 0805_L | C | 43
225 |  | C8, C9, C14 | C 0805_L | C | 3
106 |  | C11, C51, C55 | C 0805_L | C | 3
220 |  | C12, C13 | C 0805_L | C | 2
106 |  | C27 | C 1206_L | C | 1
10V/227 |  | C44, C61, C62 | CM D(6.3*7.7) | CAP | 3
105 |  | C58, C59, C60 | C 0805_L | C | 3
1N4148 |  | D1, D2 | MINI_MELF (LL34) | D | 2
SS14 |  | D3, D4 | SMA | D | 2
6.3V/0.5A | Fuse | F1 | C 0805_L | Fuse 2 | 1
Comment |  | IMPORTED_IMAGE | IMPORTED_IMAGE |  | 1
KEY_M |  | K1 | TSW SMD-3*6*2.5 | KEY_M | 1
双刀单柄开关 |  | K2 | SS-12D10 | 双刀单柄开关 | 1
4.7uH |  | L1 | CDRH74 | L | 1
LED | Typical RED, GREEN, YELLOW, AMBER GaAs LED | LED1, LED2, LED3, LED4, LED5, LED6, LED7, LED8, LED9, LED10, LED11, LED12, LED13, LED14 | LED 0805R | LED | 14
OLED-12864 | 显示屏 | OLED1 | OLED-12864-1.3-TOP | OLED-12864 | 1
BOOT select | Header, 3-Pin, Dual row | P1, P2 | HDR2.54-LI-2x3P | Header 3X2 | 2
STLINK 烧录 | Header, 4-Pin | P3 | ISP4 | Header 4 | 1
12-24V | 12-24V | P4 | KF128-5.08-2P | Header 2 | 1
USART_F(母头) |  | P5, P6, P7 | DB9/S_A | DB9母头 | 3
CAN |  | P8 | KF142V-5.08-2P | KF142V-2P | 1
KF124V |  | P9, P10, P11, P12, P13, P14, P15, P16 | KF142V-5.08-8P | KF8P, KF142V-8P | 8
S8050 | 8050/BCW846/BCW847 | Q1, Q2 | SOT23-3L | NPN | 2
4.7K |  | R1, R2, R18 | R 0805_L | R | 3
100K |  | R3, R4, R32 | R 0805_L | R | 3
10K |  | R5, R7, R8, R14, R15, R16, R23, R25, R26, R27, R28, R33, R34, R35, R36, R37, R39, R42, R48, R49, R50, R51 | R 0805_L | R | 22
36K |  | R6 | R 0805_L | R | 1
1.5K |  | R9 | R 0805_L | R | 1
5.1K |  | R10, R11, R24, R31 | R 0805_L | R | 4
22R |  | R12, R13 | R 0805_L | R | 2
100R |  | R17 | R 0805_L | R | 1
1M |  | R19, R57 | R 0805_L | R | 2
1K |  | R20, R21, R29, R30, R40, R41, R43, R44, R45, R46, R64, R65, R66, R69, R72, R77, R78, R79 | R 0805_L | R | 18
10R |  | R22 | R 0805_L | R | 1
49.9K |  | R38 | R 0805_L | R | 1
9.53K |  | R47 | R 0805_L | R | 1
47K |  | R52, R53, R54, R55, R56 | R 0805_L | R | 5
0R |  | R58, R60, R61, R62, R63 | R 0805_L | R | 5
120R |  | R59 | R 0805_L | R | 1
2K |  | R67, R70, R73, R75, R80, R82, R84, R86 | R 0805_L | R | 8
3K |  | R68, R71, R74, R76, R81, R83, R85, R87 | R 0805_L | R | 8
SD CARD |  | SD_CARD1 | SD-SMD | SD CARD | 1
STM32F407ZET6 | STM32F407ZET6 | U1 | LQFP144 20X20_L | STM32F407ZET6 | 1
STM32F103CBT6 |  | U2 | TQFP48 7x7_L | STM32F103CBT6 | 1
ESP-12F(ESP8266MOD) |  | U3 | ESP32 | ESP-12F | 1
SP3232 |  | U4, U5 | SOP16_L | MAX3232 | 2
MP2359 | DC DC Step Down IC | U6 | SOT23-6L | MP2359 | 1
CH340C |  | U7 | SOP16_L | CH340G | 1
AMS1117-3.3 |  | U8, U9 | SOT223_L | AMS1117 | 2
TJA1050 |  | U10 | SOIC-8 | SN65HVD230D | 1
SN74LVC4245APWR |  | U11, U14, U15 | TSSOP24_L | SN74LVC4245APWR | 3
TLC5615IDR |  | U12, U13 | SOIC-8 | TLC5615IDR | 2
Type-C |  | USB1, USB2 | USBTypeC-16P | USB-Type-C-TOP | 2
32.768KHz | Crystal Oscillator | Y1 | OSC 3215-2P | XTAL | 1
8MHz |  | Y2, Y3 | OSC 5032-4P | Y | 2
