BigF25/Harvester-measurement-and-control-system/1.hardware/PCBProj/参考/正点原子 STM32F407 探索者原理图和PCB图/STM32F4_V2.2料单.xlsx

STM32F4探索者料单
序号 | 料位 | 规格 | 名称 | 封装 | 数量
1 | C30, C31, C32, C33, C40, C43 | 10pF | 贴片电容 | R0603 | 6
2 | C22, C23,C41, C42, C98, C99 | 22pF | 贴片电容 | R0603 | 6
3 | C35 | 100pF | 贴片电容 | 焊100pF | 1
4 | C26 | 220pF | 贴片电容 |  | 1
5 | C34 | 1nF | 贴片电容 | R0603 | 1
6 | C83 | 10nF | 贴片电容 | R0603 | 1
7 | C29 | 22nF | 贴片电容 | R0603 | 1
8 | C1, C5, C7, C11, C13, C14, C15, C20, C21, C27, C36, C37, C38, C39, C47, C48, C49, C50, C51, C52, C53, C54, C55, C56, C57, C58, C59, C60, C61, C63, C64, C65, C66, C67, C68, C69, C70, C71, C72, C74, C75, C77, C78, C79, C80, C81, C82, C84, C86, C87, C90, C91, C93, C94, C95 | 100nF | 贴片电容 | R0603 | 55
9 | C9, C10, C16, C17, C18, C19 | 1uF | 贴片电容 | R0603 | 6
10 | C44, C45, C62 | 2.2uF | 贴片电容 | R0603 | 3
11 | C2, C3, C8, C12, C24, C25, C28, C46, C73, C76, C89, C92, C97 | 10uF | 贴片电容 | 1206 | 13
12 | C4, C6, C85, C88, C96 | 220uF | 贴片电容 | CC6.56.5 | 5
13 | R1, R13, R17, R26, R27, R31, R32 | 0R | 贴片电阻 | 焊0R | 7
14 | R7, R25, R49, R52, R53 | 10R | 贴片电阻 |  | 5
15 | R3, R4, R5, R6 | 49.9R | 贴片电阻 | 焊100R | 4
16 | R44, R51 | 120R | 贴片电阻 |  | 2
17 | R38, R40 | 360R | 贴片电阻 | 焊510R | 2
18 | R2, R18, R19, R41, R46, R47 | 510R | 贴片电阻 |  | 6
19 | R14 | 680R | 贴片电阻 |  | 1
20 | R37, R45, R59, R60, R63, R71, R72, R73 | 1K | 贴片电阻 | R0603 | 8
21 | R20, R21, R55, R57, R62, R65, R66 | 4.7K | 贴片电阻 | R0603 | 7
22 | R67 | 9.53K | 贴片电阻 | R0603 | 1
23 | R8, R9, R10, R15, R22, R24, R28, R29, R30, R33, R34, R35, R36, R54, R61, R70 | 10K | 贴片电阻 | 焊10K | 16
24 | R11 | 12.1K | 贴片电阻 |  | 1
25 | R16, R39, R42, R43, R48, R50, R58 | 47K | 贴片电阻 | 焊47K | 7
26 | R69 | 49.9K | 贴片电阻 |  | 1
27 | R56, R68 | 100K | 贴片电阻 |  | 2
28 | R12, R23, R64 | 1M | 贴片电阻 | R0603 | 3
29 | F1 | 1000mA | 保险丝 | 1206 | 1
30 | DS0 | RED | LED | D0805 | 1
31 | DS1 | GREEN | LED | D0805 | 1
32 | PWR | BLUE | LED | D0805 | 1
33 | D1, D2, D7 | 1N4148 | 二极管 | D1206 | 3
34 | D3, D4 | SS14 | 二极管 | SMB | 2
35 | D5 | SMBJ5.0A | TVS | SMBJ | 1
36 | D6 | SMBJ3.3A | TVS | SMBJ | 1
37 | L1 | 220R,2.0A,0.05DCR | 贴片磁珠 | R0603 | 1
38 | L2 | 4.7uH | 贴片电感 | L_SOP74 | 1
39 | MOS1 | SI2301 | MOS-P | SO-G3/C2.5 | 1
40 | Q1, Q2, Q3 | SS8050 | 三极管 | SOT23-3 | 3
41 | Q4 | SS8550 | 三极管 | SOT23-3 | 1
42 | U1 | LAN8720A | 网络IC | QFN24_NEW | 1
43 | U2 | WM8978 | 音频IC | qfn32 | 1
44 | U3 | IS62WV51216 | SRAMIC | TSOP44 | 1
45 | U4 | STM32F407ZET6 | MCU | LQFP144 | 1
46 | U5 | SP3232 | 通信IC | SOP16M | 1
47 | U8 | MPU6050 | 状态IC | QFN24 | 1
48 | U9 | SP3485 | 通信IC | SOP-8 | 1
49 | U10 | TJA1050 | 通信IC | SOP-8 | 1
50 | U11 | W25Q128 | FLASHIC | SOIC-8 | 1
51 | U13 | HS0038 | 红外 | HS0038 | 1
52 | U14 | 24C02 | IIPROM | SOP-8 | 1
53 | U15 | MP2359 | 电源IC | SOT-23-6 | 1
54 | U16, U18 | AMS1117-3.3 | 电源IC | AMS1117 | 2
55 | U17 | CH340G | 通信IC | SOP16M | 1
56 | PHONE | PHONE | 耳机插口 | PHONE_ST | 1
57 | LINE_IN | LINE_IN | 耳机插口 | PHONE_ST | 1
58 | LS1 | LSENS | 光敏 | SMDLED | 1
59 | Y1 | 25MHz | 晶振 | XTAL_US | 1
60 | Y2 | 8MHz | 晶振 | XTAL_US | 1
61 | Y3 | 32.768K | 晶振 | XTAL32 | 1
62 | Y4 | 12MHz | 晶振 | XTAL_US | 1
63 | MIC | MIC | MIC | MIC6027 | 1
64 | CAN | CAN | 端子 | HEAD2L-0.8 | 1
65 | RS485 | RS485 | 端子 | HEAD2L-0.8 | 1
66 | BAT | BATT | 纽扣电池 | BATM | 1
67 | BEEP | BEEP | 蜂鸣器 | BELL-5 | 1
68 | EARTHNET | RJ45 | 网口 | HR911105A | 1
69 | U6 | WIRELESS | 排母 | NRF24L01 | 1
70 | U12 | DHT11&DS18B20 | 排母 | DHT11 | 1
71 | P8 | OV2640 | 排母 | HDR2X9 | 1
72 | BOOT | Header 3X2 | 排针 | HDR2X3 | 1
73 | U7 | ATK MODULE | 排针 | HEAD6 | 1
74 | K1 | BUTTON | 排针 | BTN8.5*8.5 | 1
75 | P1 | SPEAKER | 排针 | HDR1X2 | 1
76 | P2 | Header_2 | 排针 | HDR1X2 | 1
77 | P3, P4 | HEAD2*22 | 排针 | HEAD2*22 | 2
78 | P5 | HEAD1*16 | 排针 | HDR1X16 | 1
79 | P6 | USART1 | 排针 | HDR2X2 | 1
80 | P7 | VREF_SEL | 排针 | HDR1X2 | 1
81 | P9, P10 | RS232/RS485 | 排针 | HDR2X3 | 2
82 | P11 | USB/CAN | 排针 | HDR2X3 | 1
83 | P12 | Header 4 | 排针 | HDR1X4 | 1
84 | VOUT1 | VCC3.3 | 排针 | HDR2X3 | 1
85 | VOUT2 | VCC5 | 排针 | HDR2X3 | 1
86 | JTAG | JTAG | JTAG | JTAG_20 | 1
87 | TFTLCD | TFT_LCD | TFT_LCD | db2*17-4.3 | 1
88 | COM2 | USART_F(母头) | DB9 | DB9 | 1
89 | COM3 | USART_F(公头) | DB9 | DB9 | 1
90 | USB_232 | USB | MINIUSB | MiniUSB | 1
91 | USB_SLAVE | USB-B(Mini) | MINIUSB | MiniUSB | 1
92 | USB_HOST | USB-A-90 | USB_A_90 | USB-A-90 | 1
93 | KEY0, KEY1, KEY2, KEY_UP, RESET | KEY_M | 按键 | KEY_M | 5
94 | DC_IN | POWER | POW | DC10B | 1
95 | SD_CARD，SD_CARD_2 | sd card | sd card | SDCARD_L | 2选1
96 | TPAD | ALIENTEK | TPAD | ALIENTEK_PAD2 | 1
97 | SP+, SP- | TEST_POINT | 外接喇叭 | TEST_POINT | 2
98 | H1, H2, H3, H4 | Hole | 固定孔 | Hole_4.3Y | 4
99 | Board |  |  |  | 1
