BigF25/Harvester-measurement-and-control-system/1.hardware/PCBProj/参考/正点原子 STM32F407 探索者原理图和PCB图/Project Outputs for Explorer STM32F4_V2.2/STM32F4_V2.2.xlsx

Comment | Description | Designator | Footprint | LibRef | Quantity
BATT |  | BAT | BATM | BAT | 1
BEEP |  | BEEP | BELL-5 | BEEP | 1
Header 3X2 | Header, 3-Pin, Dual row | BOOT | HDR2X3 | Header 3X2 | 1
104 | [NoValue], [NoValue], [NoValue], [NoValue], [NoValue], [NoValue], [NoValue], [NoValue], [NoValue], [NoValue], [NoValue], [NoValue], [NoValue], [NoValue], [NoValue], [NoValue], [NoValue], [NoValue], [NoValue], [NoValue], [NoValue], [NoValue], [NoValue], [NoValue], [NoValue], [NoValue], [NoValue], [NoValue], [NoValue], [NoValue], [NoValue], [NoValue], [NoValue], [NoValue], [NoValue], [NoValue], [NoValue], [NoValue], [NoValue], Capacitor (Semiconductor SIM Model), [NoValue], [NoValue], [NoValue], [NoValue], [NoValue], [NoValue], [NoValue], [NoValue], [NoValue], [NoValue], [NoValue], [NoValue], [NoValue], [NoValue], [NoValue] | C1, C5, C7, C11, C13, C14, C15, C20, C21, C27, C36, C37, C38, C39, C47, C48, C49, C50, C51, C52, C53, C54, C55, C56, C57, C58, C59, C60, C61, C63, C64, C65, C66, C67, C68, C69, C70, C71, C72, C74, C75, C77, C78, C79, C80, C81, C82, C84, C86, C87, C90, C91, C93, C94, C95 | R0603 | C, C, C, C, C, C, C, C, C, C, C, C, C, C, C, C, C, C, C, C, C, C, C, C, C, C, C, C, C, C, C, C, C, C, C, C, C, C, C, Cap Semi, C, C, C, C, C, C, C, C, C, C, C, C, C, C, C | 55
10uF | [NoValue], [NoValue], [NoValue], [NoValue], [NoValue], [NoValue], [NoValue], [NoValue], Capacitor (Semiconductor SIM Model), [NoValue], [NoValue], [NoValue], [NoValue] | C2, C3, C8, C12, C24, C25, C28, C46, C73, C76, C89, C92, C97 | 1206 | C, C, C, C, C, C, C, C, Cap Semi, C, C, C, C | 13
220uF |  | C4, C6, C85, C88, C96 | CC6.56.5 | CAP | 5
1uF |  | C9, C10, C16, C17, C18, C19 | R0603 | C | 6
22P |  | C22, C23 | R0603 | C | 2
221 |  | C26 | R0603 | C | 1
223 |  | C29 | R0603 | C | 1
10 |  | C30, C31, C32, C33, C40, C43 | R0603 | C | 6
102 |  | C34 | R0603 | C | 1
101 |  | C35 | R0603 | C | 1
22 |  | C41, C42, C98, C99 | R0603 | C | 4
225 |  | C44, C45, C62 | R0603 | C | 3
103 |  | C83 | R0603 | C | 1
CAN |  | CAN | HEAD2L-0.8 | HEAD2 | 1
USART_F(母头) |  | COM2 | DB9 | DB9 | 1
USART_F(公头) |  | COM3 | DB9 | DB9 | 1
1N4148 |  | D1, D2, D7 | DIODE_SOP | D | 3
SS14 |  | D3, D4 | DIODE_3*5.3 | D | 2
SMBJ5.0A |  | D5 | SMBJ | D | 1
SMBJ3.3A |  | D6 | SMBJ | D | 1
POWER |  | DC_IN | DC10B | POW | 1
LOGO-WeiXin |  | Designator1 | LOGO-WeiXin |  | 1
Comment |  | Designator17 | THAND |  | 1
Comment |  | Designator19 | LOGO-ALIENTEK2 |  | 1
LED1 | Typical RED, GREEN, YELLOW, AMBER GaAs LED | DS0, DS1 | SMDLED | LED2 | 2
RJ45 |  | EARTHNET | HR911105A | HR911105 | 1
1000mA |  | F1 | 1206 | R | 1
Hole |  | H1, H2, H3, H4 | Hole_4.3Y | Hole | 4
JTAG |  | JTAG | JTAG_20 | JTAG | 1
BUTTON |  | K1 | BTN8.5*8.5 | BUTTON | 1
KEY_M |  | KEY0, KEY1, KEY2, KEY_UP, RESET | KEY_M | KEY_M | 5
220R,2.0A,0.05DCR |  | L1 | R0603 | L | 1
4.7uH |  | L2 | L_SOP74 | L_SOP | 1
LINE_IN |  | LINE_IN | PHONE_ST | PHONE_M | 1
LSENS | LIGHT SENS | LS1 | SMDLED | LSENS | 1
MIC |  | MIC | MIC6027 | MIC | 1
SI2301 | IRLML6401/SI2301 | MOS1 | SO-G3/C2.5 | MOS-P | 1
SPEAKER | Header, 2-Pin | P1 | HDR1X2 | Header 2 | 1
Header_2 | Header, 2-Pin | P2 | HDR1X2 | Header 2 | 1
HEAD2*22 |  | P3, P4 | HEAD2*22 | HEAD2*22 | 2
HEAD1*16 | Header, 16-Pin | P5 | HDR1X16 | Header 16 | 1
USART1 | Header, 2-Pin, Dual row | P6 | HDR2X2 | Header 2X2 | 1
VREF_SEL | Header, 2-Pin | P7 | HDR1X2 | Header 2 | 1
OV2640 | Header, 9-Pin, Dual row | P8 | HDR2X9 | Header 9X2 | 1
RS232/RS485 | Header, 3-Pin, Dual row | P9, P10 | HDR2X3 | Header 3X2 | 2
USB/CAN | Header, 3-Pin, Dual row | P11 | HDR2X3 | Header 3X2 | 1
Header 4 | Header, 4-Pin | P12 | HDR1X4 | Header 4 | 1
PHONE |  | PHONE | PHONE_ST | PHONE_M | 1
SYS | Typical RED, GREEN, YELLOW, AMBER GaAs LED | PWR | SMDLED | LED2 | 1
SS8050 |  | Q1, Q2, Q3 | SOT23-3 | SS8050 | 3
SS8550 |  | Q4 | SOT23-3 | SS8550 | 1
0R |  | R1, R13, R17, R26, R27, R31, R32 | R0603 | R | 7
510R | [NoValue], [NoValue], [NoValue], Resistor, Resistor, Resistor | R2, R18, R19, R41, R46, R47 | R0603 | R, R, R, Res2, Res2, Res2 | 6
49.9R |  | R3, R4, R5, R6 | R0603 | R | 4
10R | [NoValue], [NoValue], Resistor, [NoValue], [NoValue] | R7, R25, R49, R52, R53 | R0603 | R, R, Res2, R, R | 5
10K |  | R8, R9, R10, R15, R22, R24, R28, R29, R30, R33, R34, R35, R36, R54, R61, R70 | R0603 | R | 16
12.1K |  | R11 | R0603 | R | 1
1M |  | R12, R23, R64 | R0603 | R | 3
680R |  | R14 | R0603 | R | 1
47K |  | R16, R39, R42, R43, R48, R50, R58 | R0603 | R | 7
4.7K |  | R20, R21, R55, R57, R62, R65, R66 | R0603 | R | 7
1K | [NoValue], Resistor, [NoValue], [NoValue], [NoValue], [NoValue], [NoValue], [NoValue] | R37, R45, R59, R60, R63, R71, R72, R73 | R0603 | R, Res2, R, R, R, R, R, R | 8
360R |  | R38, R40 | R0603 | R | 2
120R |  | R44, R51 | R0603 | R | 2
100K |  | R56, R68 | R0603 | R | 2
9.53K |  | R67 | R0603 | R | 1
49.9K |  | R69 | R0603 | R | 1
RS485 |  | RS485 | HEAD2L-0.8 | HEAD2 | 1
sd card |  | SD_CARD | SDCARD_L | sd card | 1
存储器接口 | TF存储器卡槽 | SD_CARD_2 | TF_CARD_2 | TF | 1
TEST_POINT |  | SP+, SP- | TEST_POINT | TEST_POINT | 2
TFT_LCD |  | TFTLCD | db2*17-4.3 | TFT_LCD | 1
ALIENTEK | ALIENTEK TPAD | TPAD | ALIENTEK_PAD2 | TPAD | 1
LAN8720A | ETH PHY | U1 | QFN24_NEW | LAN8720 | 1
WM8978 | 24bit ADC&DAC | U2 | qfn32 | WM8978 | 1
IS62WV51216 |  | U3 | TSOP44 | IS62WV51216 | 1
STM32F407ZET6 | STM32F407ZET6 | U4 | LQFP144 | STM32F407ZET6 | 1
SP3232 |  | U5 | SOP16M | MAX3232 | 1
WIRELESS |  | U6 | NRF24L01 | NRF24L01 | 1
ATK MODULE | ATK-HC05 | U7 | HEAD6 | ATK-HC05 | 1
MPU6050 | 9轴运动处理传感器 | U8 | QFN24 | MPU6050 | 1
SP3485 |  | U9 | SOP-8 | MAX3485 | 1
TJA1050 |  | U10 | SOP-8 | SN65HVD230D | 1
W25Q128 | W25X16;SST25VF016;MX25L1605 | U11 | SOIC-8 | W25X16 | 1
DHT11&DS18B20 | 数字温湿度传感器 | U12 | DHT11 | DHT11 | 1
HS0038 |  | U13 | HS0038 | HS0038 | 1
24C02 |  | U14 | SOP-8 | 24C256 | 1
MP2359 | DC DC Step Down IC | U15 | SOT-23-6 | MP2359 | 1
AMS1117-3.3 |  | U16, U18 | AMS1117 | AMS1117 | 2
CH340G | USB2UART | U17 | SOP16M | CH340G | 1
USB |  | USB_232 | MiniUSB/SM0.8-6H5 | USB5 | 1
USB-A-90 | USB-A-90 | USB_HOST | USB-A-90 | USB_A_90 | 1
USB-B(Mini) |  | USB_SLAVE | MiniUSB/SM0.8-6H5 | USB5 | 1
VCC3.3 | Header, 3-Pin, Dual row | VOUT1 | HDR2X3 | Header 3X2 | 1
VCC5 | Header, 3-Pin, Dual row | VOUT2 | HDR2X3 | Header 3X2 | 1
25MHz | Crystal Oscillator | Y1 | XTAL_US | XTAL | 1
8MHz | Crystal Oscillator | Y2 | XTAL_US | XTAL | 1
32.768K | Crystal Oscillator | Y3 | XTAL32 | XTAL_1 | 1
12MHz | Crystal Oscillator | Y4 | XTAL_US | XTAL_2 | 1
