BigF25/Harvester-measurement-and-control-system/3.docs/发票/工作簿1.xlsx

名称 | 型号 | 价格
模拟量采集模块 | C-7017 | 704.31
编码器采集模块 | C-5081 | 776.69
多功能混合采集模块 | C-3402 | 792
数字量采集输出模块 | C-4055 | 483
编码器采集模块 | C-5081 | 792
快递 |  | 39
快递 |  | 42
快递 |  | 40
快递 |  | 63
快递 |  | 51
快递 |  | 73
主板pcb |  | 68
 |  | 68
 |  | 900
