BigF25/Harvester-measurement-and-control-system/1.hardware/PCBProj/主板/output/原理图.pdf

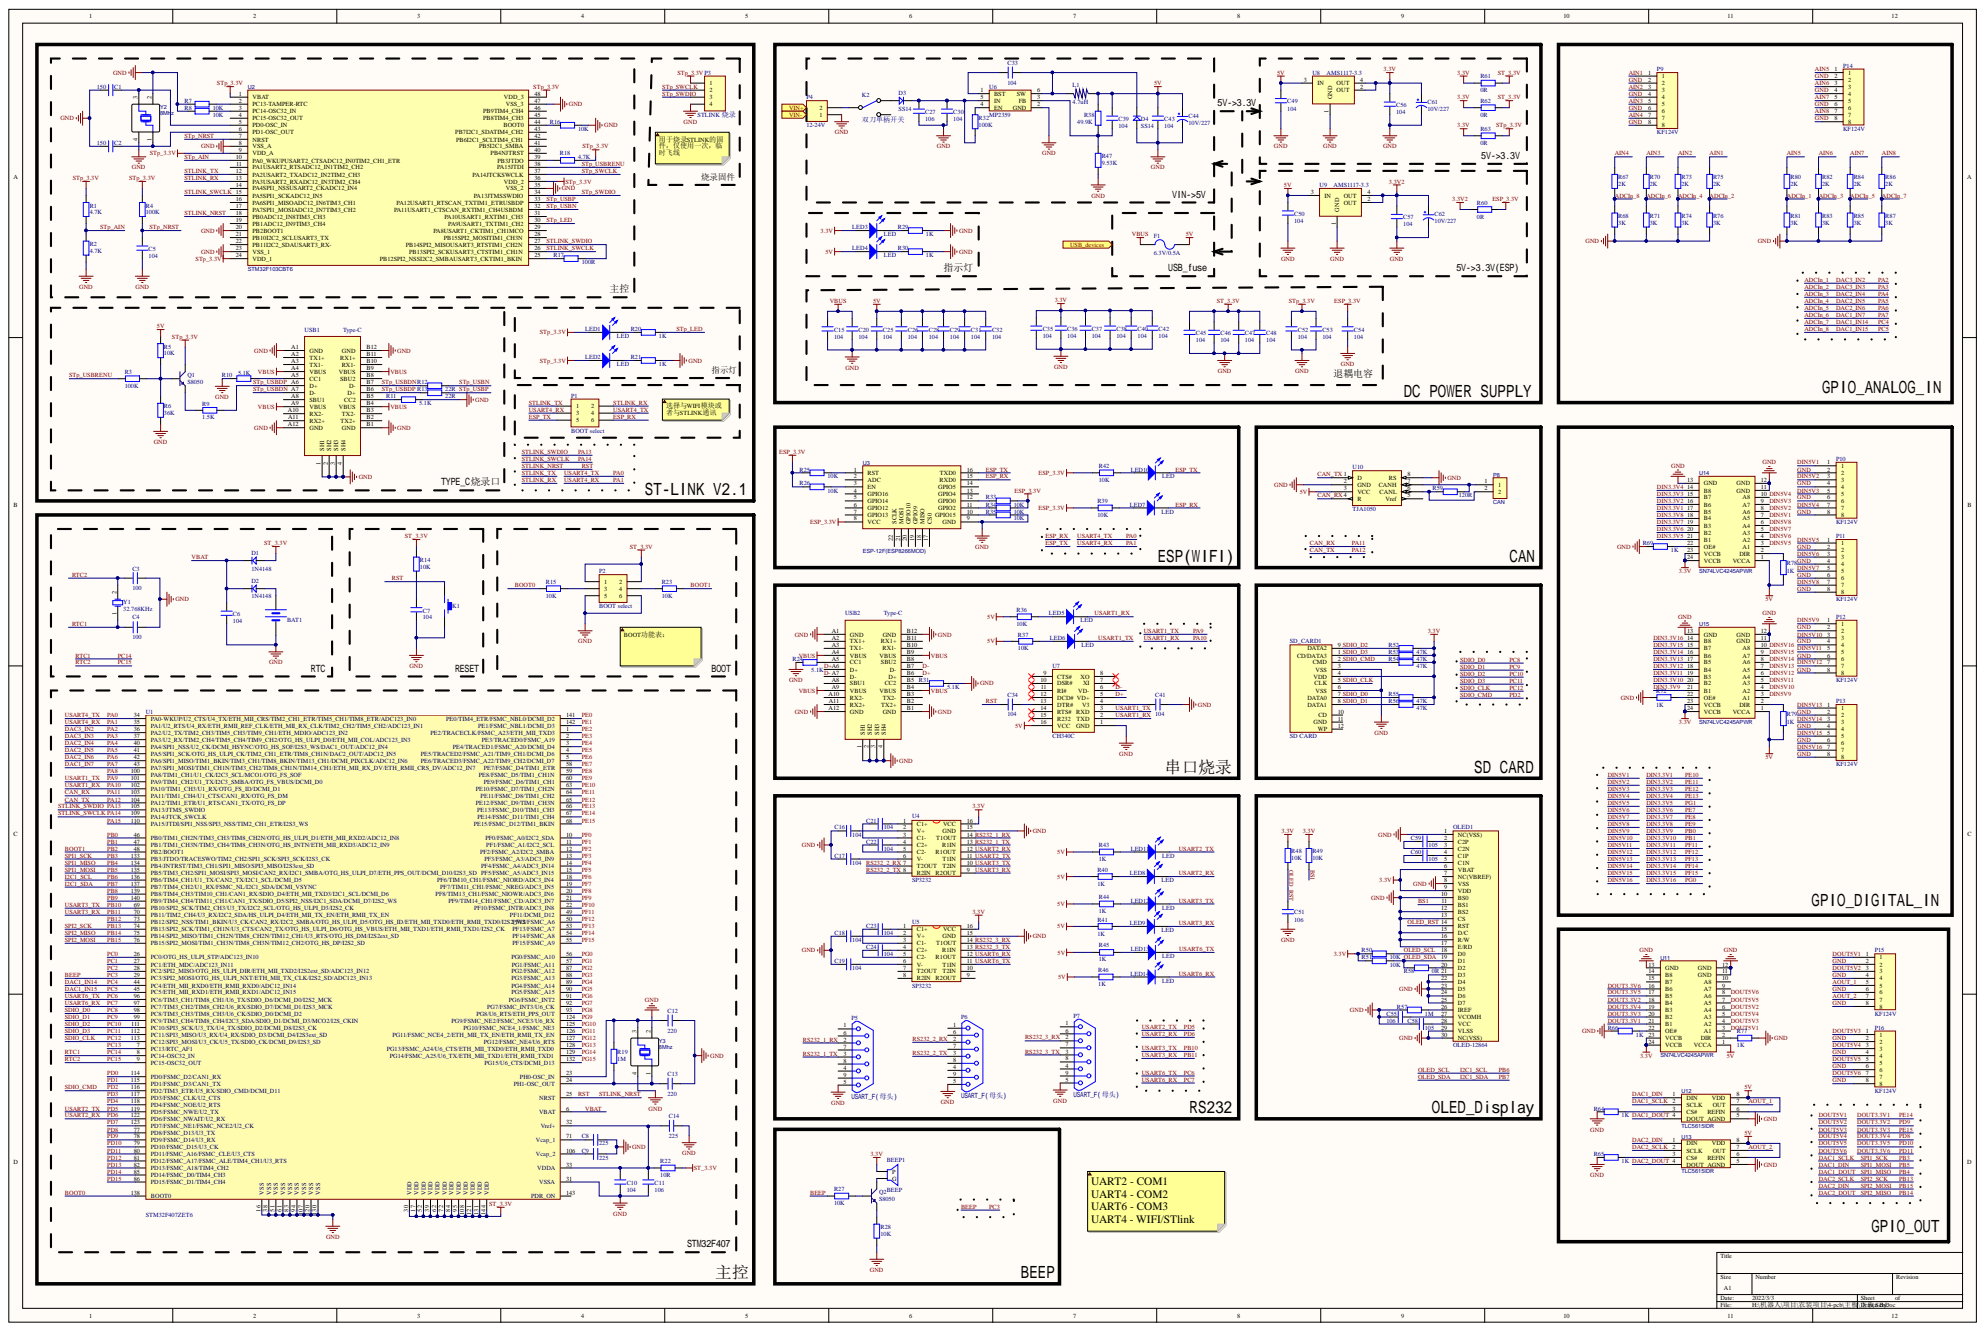
[picture p53: page 1]

STp_USBDN | | D- A7 | STp_USBDP R13 22R STp_USBP | P1

SBU1 A8 | R11 22R

RX2- A10 | | USART4_RX | | USART4_TX
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
