BigF25/Harvester-measurement-and-control-system/(list of files, drawings)

Other design files:
1.hardware/PCBProj/串口扩展/PCB_Project1.PrjPCB
1.hardware/PCBProj/串口扩展/Sheet1.SchDoc
1.hardware/PCBProj/主板/主板.PrjPCB
1.hardware/PCBProj/主板/主板.SchDoc
1.hardware/PCBProj/主板/主板.SCHLIB
1.hardware/PCBProj/参考/ST-link/F103RCT6验证板_2022-02-19.pcbdoc
1.hardware/PCBProj/参考/ST-link/PCB_Project2.PrjPCB
1.hardware/PCBProj/参考/ST-link/Sheet_1_2022-02-19.schdoc
1.hardware/PCBProj/参考/正点原子 STM32F407 探索者原理图和PCB图/AUDIO&ETHNET.SchDoc
1.hardware/PCBProj/参考/正点原子 STM32F407 探索者原理图和PCB图/CORE.SchDoc
1.hardware/PCBProj/参考/正点原子 STM32F407 探索者原理图和PCB图/DEVICES.SchDoc
1.hardware/PCBProj/参考/正点原子 STM32F407 探索者原理图和PCB图/Explorer STM32F4_V2.2.PrjPcb
1.hardware/PCBProj/参考/正点原子 STM32F407 探索者原理图和PCB图/POWER&USB_USART.SchDoc
1.hardware/PCBProj/参考/正点原子 STM32F407 探索者原理图和PCB图/STM32F4_V2.2.PcbLib
