BigF25/Harvester-measurement-and-control-system/2.software/0-library/keil5_STM32/STM32/DCDEMO7/inc/platform_config.h

/******************** (C) COPYRIGHT 2010 STMicroelectronics ********************
* File Name          : platform_config.h
* Author             : MCD Application Team
* Version            : V3.1.1
* Date               : 04/07/2010
* Description        : Evaluation board specific configuration file.
********************************************************************************
* THE PRESENT FIRMWARE WHICH IS FOR GUIDANCE ONLY AIMS AT PROVIDING CUSTOMERS
* WITH CODING INFORMATION REGARDING THEIR PRODUCTS IN ORDER FOR THEM TO SAVE TIME.
* AS A RESULT, STMICROELECTRONICS SHALL NOT BE HELD LIABLE FOR ANY DIRECT,
* INDIRECT OR CONSEQUENTIAL DAMAGES WITH RESPECT TO ANY CLAIMS ARISING FROM THE
* CONTENT OF SUCH FIRMWARE AND/OR THE USE MADE BY CUSTOMERS OF THE CODING
* INFORMATION CONTAINED HEREIN IN CONNECTION WITH THEIR PRODUCTS.
*******************************************************************************/

/* Define to prevent recursive inclusion -------------------------------------*/
#ifndef __PLATFORM_CONFIG_H
#define __PLATFORM_CONFIG_H

/* Includes ------------------------------------------------------------------*/
#include "stm32f10x.h"

/* Exported types ------------------------------------------------------------*/
/* Exported constants --------------------------------------------------------*/
/* Uncomment the line corresponding to the STMicroelectronics evaluation board
used to run the example */
#if !defined (USE_STM3210B_EVAL) &&  !defined (USE_STM3210E_EVAL)  &&  !defined (USE_STM3210C_EVAL)
#define USE_STM3210B_EVAL
//#define USE_STM3210E_EVAL
// #define USE_STM3210C_EVAL
#endif

/* Define the STM32F10x hardware depending on the used evaluation board */
//Actel_FlashPro3S 在此修改硬件配置，USB使能端
#ifdef USE_STM3210B_EVAL
#define USB_DISCONNECT                      GPIOB  
#define USB_DISCONNECT_PIN                  GPIO_Pin_15
#define RCC_APB2Periph_GPIO_DISCONNECT      RCC_APB2Periph_GPIOB
#define EVAL_COM1_IRQn                      USART1_IRQn
//结束修改
#elif defined (USE_STM3210E_EVAL)
#define USB_DISCONNECT                      GPIOB  
#define USB_DISCONNECT_PIN                  GPIO_Pin_14
#define RCC_APB2Periph_GPIO_DISCONNECT      RCC_APB2Periph_GPIOB
#define EVAL_COM1_IRQn                      USART1_IRQn

#elif defined (USE_STM3210C_EVAL)
#define USB_DISCONNECT                      0  
#define USB_DISCONNECT_PIN                  0
#define RCC_APB2Periph_GPIO_DISCONNECT      0
#define EVAL_COM1_IRQn                      USART2_IRQn

#endif /* USE_STM3210B_EVAL */

/* Exported macro ------------------------------------------------------------*/
/* Exported functions ------------------------------------------------------- */

#endif /* __PLATFORM_CONFIG_H */

/******************* (C) COPYRIGHT 2010 STMicroelectronics *****END OF FILE****/
