BigF25/Harvester-measurement-and-control-system/2.software/2-code/past/2-com_screen/dciot_build/private/ctrlboard.ini

[tcpip]

dhcp=n

ipaddr=192.168.1.100

netmask=255.255.255.0

gw=192.168.1.1

dns=192.168.1.1

server_port=5050

remote_ip=192.168.1.200

network_transfer=0

network_mode=0



[ctrlboard]

lcd_width=1024

lcd_height=768

baudrate=9600

enable_keysound=1

audiolevel=100



[wifi]

wifi_mode=0

ssid=

password=

secumode=0
