BigF25/Harvester-measurement-and-control-system/2.software/0-library/lvgl-master/src/lv_draw/lv_draw_label.c

/**
 * @file lv_draw_label.c
 *
 */

/*********************
 *      INCLUDES
 *********************/
#include "lv_draw_label.h"
#include "../lv_misc/lv_math.h"
#include "../lv_hal/lv_hal_disp.h"
#include "../lv_core/lv_refr.h"
#include "../lv_misc/lv_bidi.h"
#include "../lv_misc/lv_debug.h"

/*********************
 *      DEFINES
 *********************/
#define LABEL_RECOLOR_PAR_LENGTH 6
#define LV_LABEL_HINT_UPDATE_TH 1024 /*Update the "hint" if the label's y coordinates have changed more then this*/

/**********************
 *      TYPEDEFS
 **********************/
enum {
    CMD_STATE_WAIT,
    CMD_STATE_PAR,
    CMD_STATE_IN,
};
typedef uint8_t cmd_state_t;

/**********************
 *  STATIC PROTOTYPES
 **********************/
LV_ATTRIBUTE_FAST_MEM static void lv_draw_letter(const lv_point_t * pos_p, const lv_area_t * clip_area,
                                                 const lv_font_t * font_p,
                                                 uint32_t letter, lv_color_t color, lv_opa_t opa, lv_blend_mode_t blend_mode);
LV_ATTRIBUTE_FAST_MEM static void draw_letter_normal(lv_coord_t pos_x, lv_coord_t pos_y, lv_font_glyph_dsc_t * g,
                                                     const lv_area_t * clip_area,
                                                     const uint8_t * map_p, lv_color_t color, lv_opa_t opa, lv_blend_mode_t blend_mode);
static void draw_letter_subpx(lv_coord_t pos_x, lv_coord_t pos_y, lv_font_glyph_dsc_t * g, const lv_area_t * clip_area,
                              const uint8_t * map_p, lv_color_t color, lv_opa_t opa, lv_blend_mode_t blend_mode);

static uint8_t hex_char_to_num(char hex);

/**********************
 *  STATIC VARIABLES
 **********************/

/**********************
 *  GLOBAL VARIABLES
 **********************/

const uint8_t _lv_bpp1_opa_table[2]  = {0, 255};          /*Opacity mapping with bpp = 1 (Just for compatibility)*/
const uint8_t _lv_bpp2_opa_table[4]  = {0, 85, 170, 255}; /*Opacity mapping with bpp = 2*/

const uint8_t _lv_bpp3_opa_table[8]  = {0, 36,  73, 109,   /*Opacity mapping with bpp = 3*/
                                        146, 182,  219, 255
                                       };

const uint8_t _lv_bpp4_opa_table[16] = {0,  17, 34,  51,  /*Opacity mapping with bpp = 4*/
                                        68, 85, 102, 119,
                                        136, 153, 170, 187,
                                        204, 221, 238, 255
                                       };
const uint8_t _lv_bpp8_opa_table[256] = {0, 1, 2, 3, 4, 5, 6, 7, 8, 9, 10, 11, 12, 13, 14, 15,
                                         16, 17, 18, 19, 20, 21, 22, 23, 24, 25, 26, 27, 28, 29, 30, 31,
                                         32, 33, 34, 35, 36, 37, 38, 39, 40, 41, 42, 43, 44, 45, 46, 47,
                                         48, 49, 50, 51, 52, 53, 54, 55, 56, 57, 58, 59, 60, 61, 62, 63,
                                         64, 65, 66, 67, 68, 69, 70, 71, 72, 73, 74, 75, 76, 77, 78, 79,
                                         80, 81, 82, 83, 84, 85, 86, 87, 88, 89, 90, 91, 92, 93, 94, 95,
                                         96, 97, 98, 99, 100, 101, 102, 103, 104, 105, 106, 107, 108, 109, 110, 111,
                                         112, 113, 114, 115, 116, 117, 118, 119, 120, 121, 122, 123, 124, 125, 126, 127,
                                         128, 129, 130, 131, 132, 133, 134, 135, 136, 137, 138, 139, 140, 141, 142, 143,
                                         144, 145, 146, 147, 148, 149, 150, 151, 152, 153, 154, 155, 156, 157, 158, 159,
                                         160, 161, 162, 163, 164, 165, 166, 167, 168, 169, 170, 171, 172, 173, 174, 175,
                                         176, 177, 178, 179, 180, 181, 182, 183, 184, 185, 186, 187, 188, 189, 190, 191,
                                         192, 193, 194, 195, 196, 197, 198, 199, 200, 201, 202, 203, 204, 205, 206, 207,
                                         208, 209, 210, 211, 212, 213, 214, 215, 216, 217, 218, 219, 220, 221, 222, 223,
                                         224, 225, 226, 227, 228, 229, 230, 231, 232, 233, 234, 235, 236, 237, 238, 239,
                                         240, 241, 242, 243, 244, 245, 246, 247, 248, 249, 250, 251, 252, 253, 254, 255
                                        };

/**********************
 *      MACROS
 **********************/

/**********************
 *   GLOBAL FUNCTIONS
 **********************/

LV_ATTRIBUTE_FAST_MEM void lv_draw_label_dsc_init(lv_draw_label_dsc_t * dsc)
{
    _lv_memset_00(dsc, sizeof(lv_draw_label_dsc_t));
    dsc->opa = LV_OPA_COVER;
    dsc->color = LV_COLOR_BLACK;
    dsc->font = LV_THEME_DEFAULT_FONT_NORMAL;
    dsc->sel_start = LV_DRAW_LABEL_NO_TXT_SEL;
    dsc->sel_end = LV_DRAW_LABEL_NO_TXT_SEL;
    dsc->sel_color = LV_COLOR_BLACK;
    dsc->sel_bg_color = LV_COLOR_BLUE;
    dsc->bidi_dir = LV_BIDI_DIR_LTR;
}

/**
 * Write a text
 * @param coords coordinates of the label
 * @param mask the label will be drawn only in this area
 * @param dsc pointer to draw descriptor
 * @param txt `\0` terminated text to write
 * @param hint pointer to a `lv_draw_label_hint_t` variable.
 * It is managed by the drawer to speed up the drawing of very long texts (thousands of lines).
 */
LV_ATTRIBUTE_FAST_MEM void lv_draw_label(const lv_area_t * coords, const lv_area_t * mask,
                                         const lv_draw_label_dsc_t * dsc,
                                         const char * txt,
                                         lv_draw_label_hint_t * hint)
{

    if(dsc->opa <= LV_OPA_MIN) return;
    const lv_font_t * font = dsc->font;
    int32_t w;

    /*No need to waste processor time if string is empty*/
    if(txt[0] == '\0')  return;

    lv_area_t clipped_area;
    bool clip_ok = _lv_area_intersect(&clipped_area, coords, mask);
    if(!clip_ok) return;

    if((dsc->flag & LV_TXT_FLAG_EXPAND) == 0) {
        /*Normally use the label's width as width*/
        w = lv_area_get_width(coords);
    }
    else {
        /*If EXAPND is enabled then not limit the text's width to the object's width*/
        lv_point_t p;
        _lv_txt_get_size(&p, txt, dsc->font, dsc->letter_space, dsc->line_space, LV_COORD_MAX,
                         dsc->flag);
        w = p.x;
    }

    int32_t line_height_font = lv_font_get_line_height(font);
    int32_t line_height = line_height_font + dsc->line_space;

    /*Init variables for the first line*/
    int32_t line_width = 0;
    lv_point_t pos;
    pos.x = coords->x1;
    pos.y = coords->y1;

    int32_t x_ofs = 0;
    int32_t y_ofs = 0;
    x_ofs = dsc->ofs_x;
    y_ofs = dsc->ofs_y;
    pos.y += y_ofs;

    uint32_t line_start     = 0;
    int32_t last_line_start = -1;

    /*Check the hint to use the cached info*/
    if(hint && y_ofs == 0 && coords->y1 < 0) {
        /*If the label changed too much recalculate the hint.*/
        if(LV_MATH_ABS(hint->coord_y - coords->y1) > LV_LABEL_HINT_UPDATE_TH - 2 * line_height) {
            hint->line_start = -1;
        }
        last_line_start = hint->line_start;
    }

    /*Use the hint if it's valid*/
    if(hint && last_line_start >= 0) {
        line_start = last_line_start;
        pos.y += hint->y;
    }

    uint32_t line_end = line_start + _lv_txt_get_next_line(&txt[line_start], font, dsc->letter_space, w, dsc->flag);

    /*Go the first visible line*/
    while(pos.y + line_height_font < mask->y1) {
        /*Go to next line*/
        line_start = line_end;
        line_end += _lv_txt_get_next_line(&txt[line_start], font, dsc->letter_space, w, dsc->flag);
        pos.y += line_height;

        /*Save at the threshold coordinate*/
        if(hint && pos.y >= -LV_LABEL_HINT_UPDATE_TH && hint->line_start < 0) {
            hint->line_start = line_start;
            hint->y          = pos.y - coords->y1;
            hint->coord_y    = coords->y1;
        }

        if(txt[line_start] == '\0') return;
    }

    /*Align to middle*/
    if(dsc->flag & LV_TXT_FLAG_CENTER) {
        line_width = _lv_txt_get_width(&txt[line_start], line_end - line_start, font, dsc->letter_space, dsc->flag);

        pos.x += (lv_area_get_width(coords) - line_width) / 2;

    }
    /*Align to the right*/
    else if(dsc->flag & LV_TXT_FLAG_RIGHT) {
        line_width = _lv_txt_get_width(&txt[line_start], line_end - line_start, font, dsc->letter_space, dsc->flag);
        pos.x += lv_area_get_width(coords) - line_width;
    }

    lv_opa_t opa = dsc->opa;

    uint32_t sel_start = dsc->sel_start;
    uint32_t sel_end = dsc->sel_end;
    if(sel_start > sel_end) {
        uint32_t tmp = sel_start;
        sel_start = sel_end;
        sel_end = tmp;
    }
    lv_draw_line_dsc_t line_dsc;

    if((dsc->decor & LV_TEXT_DECOR_UNDERLINE) || (dsc->decor & LV_TEXT_DECOR_STRIKETHROUGH)) {
        lv_draw_line_dsc_init(&line_dsc);
        line_dsc.color = dsc->color;
        line_dsc.width = font->underline_thickness ? font->underline_thickness : 1;
        line_dsc.opa = dsc->opa;
        line_dsc.blend_mode = dsc->blend_mode;
    }

    cmd_state_t cmd_state = CMD_STATE_WAIT;
    uint32_t i;
    uint32_t par_start = 0;
    lv_color_t recolor;
    int32_t letter_w;

    lv_draw_rect_dsc_t draw_dsc_sel;
    lv_draw_rect_dsc_init(&draw_dsc_sel);
    draw_dsc_sel.bg_color = dsc->sel_bg_color;

    int32_t pos_x_start = pos.x;
    /*Write out all lines*/
    while(txt[line_start] != '\0') {
        pos.x += x_ofs;

        /*Write all letter of a line*/
        cmd_state = CMD_STATE_WAIT;
        i         = 0;
#if LV_USE_BIDI
        char * bidi_txt = _lv_mem_buf_get(line_end - line_start + 1);
        _lv_bidi_process_paragraph(txt + line_start, bidi_txt, line_end - line_start, dsc->bidi_dir, NULL, 0);
#else
        const char * bidi_txt = txt + line_start;
#endif

        while(i < line_end - line_start) {
            uint32_t logical_char_pos = 0;
            if(sel_start != 0xFFFF && sel_end != 0xFFFF) {
#if LV_USE_BIDI
                logical_char_pos = _lv_txt_encoded_get_char_id(txt, line_start);
                uint32_t t = _lv_txt_encoded_get_char_id(bidi_txt, i);
                logical_char_pos += _lv_bidi_get_logical_pos(bidi_txt, NULL, line_end - line_start, dsc->bidi_dir, t, NULL);
#else
                logical_char_pos = _lv_txt_encoded_get_char_id(txt, line_start + i);
#endif
            }

            uint32_t letter      = _lv_txt_encoded_next(bidi_txt, &i);
            uint32_t letter_next = _lv_txt_encoded_next(&bidi_txt[i], NULL);

            /*Handle the re-color command*/
            if((dsc->flag & LV_TXT_FLAG_RECOLOR) != 0) {
                if(letter == (uint32_t)LV_TXT_COLOR_CMD[0]) {
                    if(cmd_state == CMD_STATE_WAIT) { /*Start char*/
                        par_start = i;
                        cmd_state = CMD_STATE_PAR;
                        continue;
                    }
                    else if(cmd_state == CMD_STATE_PAR) {   /*Other start char in parameter escaped cmd. char */
                        cmd_state = CMD_STATE_WAIT;
                    }
                    else if(cmd_state == CMD_STATE_IN) {   /*Command end */
                        cmd_state = CMD_STATE_WAIT;
                        continue;
                    }
                }

                /*Skip the color parameter and wait the space after it*/
                if(cmd_state == CMD_STATE_PAR) {
                    if(letter == ' ') {
                        /*Get the parameter*/
                        if(i - par_start == LABEL_RECOLOR_PAR_LENGTH + 1) {
                            char buf[LABEL_RECOLOR_PAR_LENGTH + 1];
                            _lv_memcpy_small(buf, &bidi_txt[par_start], LABEL_RECOLOR_PAR_LENGTH);
                            buf[LABEL_RECOLOR_PAR_LENGTH] = '\0';
                            int r, g, b;
                            r       = (hex_char_to_num(buf[0]) << 4) + hex_char_to_num(buf[1]);
                            g       = (hex_char_to_num(buf[2]) << 4) + hex_char_to_num(buf[3]);
                            b       = (hex_char_to_num(buf[4]) << 4) + hex_char_to_num(buf[5]);
                            recolor = lv_color_make(r, g, b);
                        }
                        else {
                            recolor.full = dsc->color.full;
                        }
                        cmd_state = CMD_STATE_IN; /*After the parameter the text is in the command*/
                    }
                    continue;
                }
            }

            lv_color_t color = dsc->color;

            if(cmd_state == CMD_STATE_IN) color = recolor;

            letter_w = lv_font_get_glyph_width(font, letter, letter_next);

            if(sel_start != 0xFFFF && sel_end != 0xFFFF) {
                if(logical_char_pos >= sel_start && logical_char_pos < sel_end) {
                    lv_area_t sel_coords;
                    sel_coords.x1 = pos.x;
                    sel_coords.y1 = pos.y;
                    sel_coords.x2 = pos.x + letter_w + dsc->letter_space - 1;
                    sel_coords.y2 = pos.y + line_height - 1;
                    lv_draw_rect(&sel_coords, mask, &draw_dsc_sel);
                    color = dsc->sel_color;
                }
            }

            lv_draw_letter(&pos, mask, font, letter, color, opa, dsc->blend_mode);

            if(letter_w > 0) {
                pos.x += letter_w + dsc->letter_space;
            }
        }

        if(dsc->decor & LV_TEXT_DECOR_STRIKETHROUGH) {
            lv_point_t p1;
            lv_point_t p2;
            p1.x = pos_x_start;
            p1.y = pos.y + (dsc->font->line_height / 2)  + line_dsc.width / 2;
            p2.x = pos.x;
            p2.y = p1.y;
            lv_draw_line(&p1, &p2, mask, &line_dsc);
        }

        if(dsc->decor  & LV_TEXT_DECOR_UNDERLINE) {
            lv_point_t p1;
            lv_point_t p2;
            p1.x = pos_x_start;
            p1.y = pos.y + dsc->font->line_height - dsc->font->base_line - font->underline_position;
            p2.x = pos.x;
            p2.y = p1.y;
            lv_draw_line(&p1, &p2, mask, &line_dsc);
        }

#if LV_USE_BIDI
        _lv_mem_buf_release(bidi_txt);
        bidi_txt = NULL;
#endif
        /*Go to next line*/
        line_start = line_end;
        line_end += _lv_txt_get_next_line(&txt[line_start], font, dsc->letter_space, w, dsc->flag);

        pos.x = coords->x1;
        /*Align to middle*/
        if(dsc->flag & LV_TXT_FLAG_CENTER) {
            line_width =
                _lv_txt_get_width(&txt[line_start], line_end - line_start, font, dsc->letter_space, dsc->flag);

            pos.x += (lv_area_get_width(coords) - line_width) / 2;

        }
        /*Align to the right*/
        else if(dsc->flag & LV_TXT_FLAG_RIGHT) {
            line_width =
                _lv_txt_get_width(&txt[line_start], line_end - line_start, font, dsc->letter_space, dsc->flag);
            pos.x += lv_area_get_width(coords) - line_width;
        }

        /*Go the next line position*/
        pos.y += line_height;

        if(pos.y > mask->y2) return;
    }

    LV_ASSERT_MEM_INTEGRITY();
}

/**********************
 *   STATIC FUNCTIONS
 **********************/

/**
 * Draw a letter in the Virtual Display Buffer
 * @param pos_p left-top coordinate of the latter
 * @param mask_p the letter will be drawn only on this area  (truncated to VDB area)
 * @param font_p pointer to font
 * @param letter a letter to draw
 * @param color color of letter
 * @param opa opacity of letter (0..255)
 */
LV_ATTRIBUTE_FAST_MEM static void lv_draw_letter(const lv_point_t * pos_p, const lv_area_t * clip_area,
                                                 const lv_font_t * font_p,
                                                 uint32_t letter,
                                                 lv_color_t color, lv_opa_t opa, lv_blend_mode_t blend_mode)
{
    if(opa < LV_OPA_MIN) return;
    if(opa > LV_OPA_MAX) opa = LV_OPA_COVER;

    if(font_p == NULL) {
        LV_LOG_WARN("lv_draw_letter: font is NULL");
        return;
    }

    lv_font_glyph_dsc_t g;
    bool g_ret = lv_font_get_glyph_dsc(font_p, &g, letter, '\0');
    if(g_ret == false)  {
        /* Add warning if the dsc is not found
         * but do not print warning for non printable ASCII chars (e.g. '\n')*/
        if(letter >= 0x20) {
            LV_LOG_WARN("lv_draw_letter: glyph dsc. not found");
        }
        return;
    }

    /* Don't draw anything if the character is empty. E.g. space */
    if((g.box_h == 0) || (g.box_w == 0)) return;

    int32_t pos_x = pos_p->x + g.ofs_x;
    int32_t pos_y = pos_p->y + (font_p->line_height - font_p->base_line) - g.box_h - g.ofs_y;

    /*If the letter is completely out of mask don't draw it */
    if(pos_x + g.box_w < clip_area->x1 ||
       pos_x > clip_area->x2 ||
       pos_y + g.box_h < clip_area->y1 ||
       pos_y > clip_area->y2)  {
        return;
    }

    const uint8_t * map_p = lv_font_get_glyph_bitmap(font_p, letter);
    if(map_p == NULL) {
        LV_LOG_WARN("lv_draw_letter: character's bitmap not found");
        return;
    }

    if(font_p->subpx) {
        draw_letter_subpx(pos_x, pos_y, &g, clip_area, map_p, color, opa, blend_mode);
    }
    else {
        draw_letter_normal(pos_x, pos_y, &g, clip_area, map_p, color, opa, blend_mode);
    }
}
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
