BigF25/Harvester-measurement-and-control-system/2.software/0-library/lvgl-master/src/lv_draw/lv_draw_line.c

/**
 * @file lv_draw_line.c
 *
 */

/*********************
 *      INCLUDES
 *********************/
#include <stdio.h>
#include <stdbool.h>
#include "lv_draw_mask.h"
#include "lv_draw_blend.h"
#include "../lv_core/lv_refr.h"
#include "../lv_misc/lv_math.h"

/*********************
 *      DEFINES
 *********************/

/**********************
 *      TYPEDEFS
 **********************/

/**********************
 *  STATIC PROTOTYPES
 **********************/
LV_ATTRIBUTE_FAST_MEM static void draw_line_skew(const lv_point_t * point1, const lv_point_t * point2,
                                                 const lv_area_t * clip,
                                                 const lv_draw_line_dsc_t * dsc);
LV_ATTRIBUTE_FAST_MEM static void draw_line_hor(const lv_point_t * point1, const lv_point_t * point2,
                                                const lv_area_t * clip,
                                                const lv_draw_line_dsc_t * dsc);
LV_ATTRIBUTE_FAST_MEM static void draw_line_ver(const lv_point_t * point1, const lv_point_t * point2,
                                                const lv_area_t * clip,
                                                const lv_draw_line_dsc_t * dsc);

/**********************
 *  STATIC VARIABLES
 **********************/

/**********************
 *      MACROS
 **********************/

/**********************
 *   GLOBAL FUNCTIONS
 **********************/

LV_ATTRIBUTE_FAST_MEM void lv_draw_line_dsc_init(lv_draw_line_dsc_t * dsc)
{
    _lv_memset_00(dsc, sizeof(lv_draw_line_dsc_t));
    dsc->width = 1;
    dsc->opa = LV_OPA_COVER;
    dsc->color = LV_COLOR_BLACK;
}

/**
 * Draw a line
 * @param point1 first point of the line
 * @param point2 second point of the line
 * @param clip the line will be drawn only in this area
 * @param dsc pointer to an initialized `lv_draw_line_dsc_t` variable
 */
LV_ATTRIBUTE_FAST_MEM void lv_draw_line(const lv_point_t * point1, const lv_point_t * point2, const lv_area_t * clip,
                                        const lv_draw_line_dsc_t * dsc)
{
    if(dsc->width == 0) return;
    if(dsc->opa <= LV_OPA_MIN) return;

    if(point1->x == point2->x && point1->y == point2->y) return;

    lv_area_t clip_line;
    clip_line.x1 = LV_MATH_MIN(point1->x, point2->x) - dsc->width / 2;
    clip_line.x2 = LV_MATH_MAX(point1->x, point2->x) + dsc->width / 2;
    clip_line.y1 = LV_MATH_MIN(point1->y, point2->y) - dsc->width / 2;
    clip_line.y2 = LV_MATH_MAX(point1->y, point2->y) + dsc->width / 2;

    bool is_common;
    is_common = _lv_area_intersect(&clip_line, &clip_line, clip);
    if(!is_common) return;

    if(point1->y == point2->y) draw_line_hor(point1, point2, &clip_line, dsc);
    else if(point1->x == point2->x) draw_line_ver(point1, point2, &clip_line, dsc);
    else draw_line_skew(point1, point2, &clip_line, dsc);

    if(dsc->round_end || dsc->round_start) {
        lv_draw_rect_dsc_t cir_dsc;
        lv_draw_rect_dsc_init(&cir_dsc);
        cir_dsc.bg_color = dsc->color;
        cir_dsc.radius = LV_RADIUS_CIRCLE;
        cir_dsc.bg_opa = dsc->opa;

        int32_t r = (dsc->width >> 1);
        int32_t r_corr = (dsc->width & 1) ? 0 : 1;
        lv_area_t cir_area;

        if(dsc->round_start) {
            cir_area.x1 = point1->x - r;
            cir_area.y1 = point1->y - r;
            cir_area.x2 = point1->x + r - r_corr;
            cir_area.y2 = point1->y + r - r_corr ;
            lv_draw_rect(&cir_area, clip, &cir_dsc);
        }

        if(dsc->round_end) {
            cir_area.x1 = point2->x - r;
            cir_area.y1 = point2->y - r;
            cir_area.x2 = point2->x + r - r_corr;
            cir_area.y2 = point2->y + r - r_corr ;
            lv_draw_rect(&cir_area, clip, &cir_dsc);
        }
    }
}

/**********************
 *   STATIC FUNCTIONS
 **********************/
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
