BigF25/Harvester-measurement-and-control-system/(commit log)

2022-06-28 PCB 参考资料
    [AUDIO&ETHNET.SchDoc, CORE.SchDoc, DEVICES.SchDoc, Explorer STM32F4_V2.2.PrjPcb, F103RCT6验证板_2022-02-19.pcbdoc, PCB_Project1.PrjPCB, PCB_Project2.PrjPCB, POWER&USB_USART.SchDoc]
2022-06-28 第一次打板
    [主板.PrjPCB, 主板.SchDoc]
2022-06-28 第二次打板
    [BOM.xls, 主板.PrjPCB, 主板.SCHLIB, 主板.SchDoc]
2022-07-20 “CodeInit”
    [5801_2022-05-06 22h.xls, 7017_2022-05-06 22h.xls, code-format.cfg, 工作簿1.xlsx]
