BigF25/Harvester-measurement-and-control-system/(notices)

Notices in the files:
2.software/2-code/past/2-version2_coding（最新）/USMART/usmart.c:
Copyright(C) ÕýµãÔ­×Ó 2011-2021
All rights reserved
2.software/2-code/past/2-version2_coding（最新）/HARDWARE/TOUCH/touch.c:
Copyright(C) ¹ãÖÝÊÐÐÇÒíµç×Ó¿Æ¼¼ÓÐÏÞ¹«Ë¾ 2014-2024
